promesoft/KicadJE_LIB/aj_symbols/lib_master/KiCAD Schematic Library Format.xlsx

Sheet: Schematic Decal Header
Comment | Component Name
#
# | 74LS04
#

Sheet: Schematic Decal Definition
Schematic Decal Definition
DEF 74HCT04 U 0 30 Y Y 6 F N |  |  |  |  |  |  |  |  |  | DEF 74HCT04 U 0 0 Y Y 6 F N
Defininition Statement | Decal Name | Default Ref Des |  | Skew | Show Pin Num | Show Pin Name | Num Parts | Locked | Power
DEF | 74LS02 | U | 0 | 30 | Y | Y | 6 | F | N

Sheet: Schematic Text Field Definition
Schematic Text Field Definition
F0 "U" 150 100 40 H V C CNN
F1 "74HCT04" 200 -100 40 H V C CNN
 |  |  |  |  |  |  |  |  | Text Style
Text Field Designator | Text | X Pos | Y Pos | Text Size | Text Direction | Visibility | Horz Just | Vert Just | Normal Italic | Normal Bold
F0 | "U" | 150 | 100 | 40 | H | V | C | C | N | N | No spaces between last three characters
F1 | "74HCT04" | 200 | -100 | 40 | H | V | C | C | N | N

Sheet: Schematic Alias Definition
Schematic Alias Definition
ALIAS 74HC14 74HC04 74LS14
Alias Designator | Alias 1 | Alias 2 | Alias 3 | Alias n
ALIAS | 74HC14 | 74HC04 | 74LS14

Sheet: Schematic Draw Definition
Schematic Draw Definition
P 4 0 0 0 -150 150 -150 -150 150 0 -150 150 N
DRAW
Line Style | Num Points |  |  |  | Point 1 X Coord | Point 1 Y Coord | Point 2 X Coord | Point 2 Y Coord | Point 3 X Coord | Point 3 Y Coord | Point 4 X Coord | Point 4 Y Coord | Fill Options
P | 4 | 0 | 0 | 0 | -150 | 150 | -150 | -150 | 150 | 0 | -150 | 150 | N

Sheet: Schematic Pin Definition
Schematic Pin Definition
X GND 7 -50 -100 0 U 30 20 0 0 W N
X ~ 1 -450 0 300 R 60 60 1 1 I
X ~ 2 450 0 300 L 60 60 1 1 O I
Field Names
Pin Designator | Pin Name | Pin Num | Pos | Pos
X | GND | 7 | -50 | -100 | 0 | U | 30 | 20 | 0 | 0 | W | N
X | ~ | 1 | -450 | 0 | 300 | R | 60 | 60 | 1 | 1 | I
X | ~ | 2 | 450 | 0 | 300 | L | 60 | 60 | 1 | 1 | I
