promesoft/KicadJE_LIB/aj_packages3d/3D/Switch/SPDT-draft.png

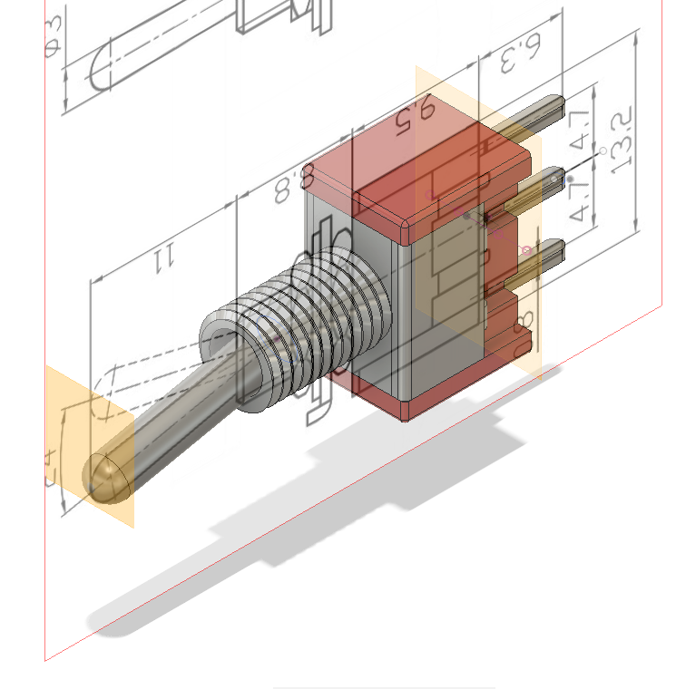
aj_packages3d/3D/Switch/SPDT-draft.png
