promesoft/KicadJE_LIB/aj_templates/MikroBUS_Board_L_Template/meta/brd.png

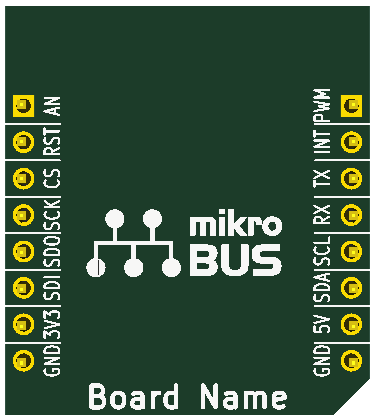
aj_templates/MikroBUS_Board_L_Template/meta/brd.png
