promesoft/KicadJE_LIB/aj_templates/XBee/meta/brd.png

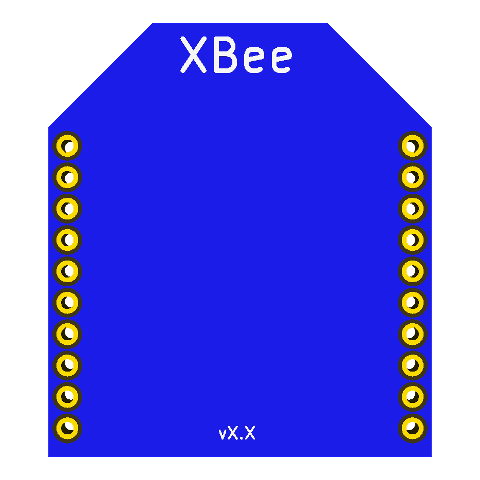
aj_templates/XBee/meta/brd.png
