promesoft/KicadJE_LIB/aj_templates/XBee/XBee_Info/XBee_Standard_Pinout.PNG

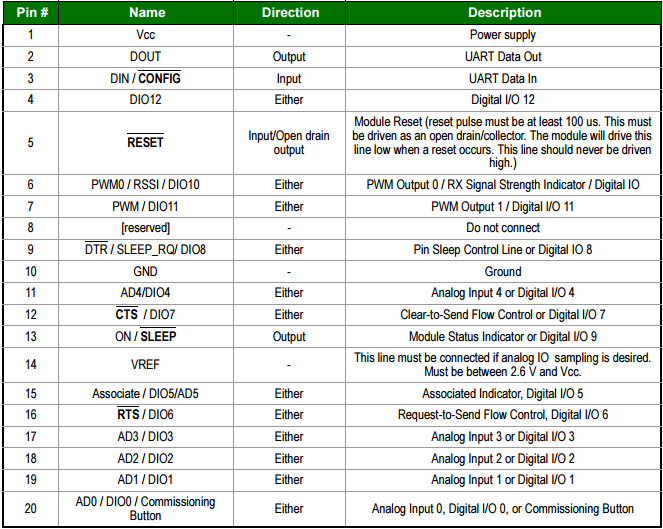
aj_templates/XBee/XBee_Info/XBee_Standard_Pinout.PNG
