promesoft/KicadJE_LIB/aj_templates/XBee_Pro/meta/brd.png

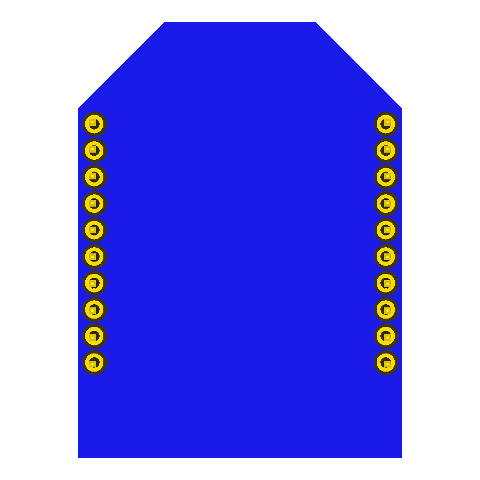
aj_templates/XBee_Pro/meta/brd.png
