promesoft/KicadJE_LIB/aj_symbols/lib_master/KiCAD_Schematic_Library_Info.ods

Sheet: Library_Names
74xx
Active
Altera
ARM
AVR
Battery
CMOS
Connector
Display
Electromechanical
Fuse
Header
IC
MSP430
PIC
Passive
Potentiometer
Power Supplies
RF_Modules
Terminal Block
Test_Point
TI_Luminary
TI_MSP430
Xilinx

Sheet: Active
DIODE
NPN
N_MOSFET
P_MOSFET
PNP
TRIAC
SCR

Sheet: Header
Schematic Component Name | Component Type | Gender | Pitch |  | Rows | Positions | Mounting Type
HEADER_100MIL_1R01P_SMT | HEADER | FEMALE | 100 | MIL | 1 | 01 | SMT
HEADER_100MIL_1R02P_SMT | HEADER | FEMALE | 100 | MIL | 1 | 02 | SMT
HEADER_100MIL_1R03P_SMT | HEADER | FEMALE | 100 | MIL | 1 | 03 | SMT
HEADER_100MIL_1R04P_SMT | HEADER | FEMALE | 100 | MIL | 1 | 04 | SMT
HEADER_100MIL_1R05P_SMT | HEADER | FEMALE | 100 | MIL | 1 | 05 | SMT
HEADER_100MIL_1R06P_SMT | HEADER | FEMALE | 100 | MIL | 1 | 06 | SMT
HEADER_100MIL_1R07P_SMT | HEADER | FEMALE | 100 | MIL | 1 | 07 | SMT
HEADER_100MIL_1R08P_SMT | HEADER | FEMALE | 100 | MIL | 1 | 08 | SMT
HEADER_100MIL_1R09P_SMT | HEADER | FEMALE | 100 | MIL | 1 | 09 | SMT
HEADER_100MIL_1R10P_SMT | HEADER | FEMALE | 100 | MIL | 1 | 10 | SMT
HEADER_100MIL_1R11P_SMT | HEADER | FEMALE | 100 | MIL | 1 | 11 | SMT
HEADER_100MIL_1R12P_SMT | HEADER | FEMALE | 100 | MIL | 1 | 12 | SMT
HEADER_100MIL_1R13P_SMT | HEADER | FEMALE | 100 | MIL | 1 | 13 | SMT
HEADER_100MIL_1R14P_SMT | HEADER | FEMALE | 100 | MIL | 1 | 14 | SMT
HEADER_100MIL_1R15P_SMT | HEADER | FEMALE | 100 | MIL | 1 | 15 | SMT
HEADER_100MIL_1R16P_SMT | HEADER | FEMALE | 100 | MIL | 1 | 16 | SMT
HEADER_100MIL_1R17P_SMT | HEADER | FEMALE | 100 | MIL | 1 | 17 | SMT
HEADER_100MIL_1R18P_SMT | HEADER | FEMALE | 100 | MIL | 1 | 18 | SMT
HEADER_100MIL_1R19P_SMT | HEADER | FEMALE | 100 | MIL | 1 | 19 | SMT
HEADER_100MIL_1R20P_SMT | HEADER | FEMALE | 100 | MIL | 1 | 20 | SMT
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
HEADER_100MIL_2R30P_PTH | HEADER | MALE | 100 | MIL | 2 | 30 | PTH
HEADER_100MIL_2R31P_PTH | HEADER | MALE | 100 | MIL | 2 | 31 | PTH
HEADER_100MIL_2R32P_PTH | HEADER | MALE | 100 | MIL | 2 | 32 | PTH
HEADER_100MIL_2R33P_PTH | HEADER | MALE | 100 | MIL | 2 | 33 | PTH
HEADER_100MIL_2R34P_PTH | HEADER | MALE | 100 | MIL | 2 | 34 | PTH
HEADER_100MIL_2R35P_PTH | HEADER | MALE | 100 | MIL | 2 | 35 | PTH
HEADER_100MIL_2R36P_PTH | HEADER | MALE | 100 | MIL | 2 | 36 | PTH
HEADER_100MIL_2R37P_PTH | HEADER | MALE | 100 | MIL | 2 | 37 | PTH
HEADER_100MIL_2R38P_PTH | HEADER | MALE | 100 | MIL | 2 | 38 | PTH
HEADER_100MIL_2R39P_PTH | HEADER | MALE | 100 | MIL | 2 | 39 | PTH
HEADER_100MIL_2R40P_PTH | HEADER | MALE | 100 | MIL | 2 | 40 | PTH
HEADER_100MIL_2R41P_PTH | HEADER | MALE | 100 | MIL | 2 | 41 | PTH
HEADER_100MIL_2R42P_PTH | HEADER | MALE | 100 | MIL | 2 | 42 | PTH
HEADER_100MIL_2R43P_PTH | HEADER | MALE | 100 | MIL | 2 | 43 | PTH
HEADER_100MIL_2R44P_PTH | HEADER | MALE | 100 | MIL | 2 | 44 | PTH
HEADER_100MIL_2R45P_PTH | HEADER | MALE | 100 | MIL | 2 | 45 | PTH
HEADER_100MIL_2R46P_PTH | HEADER | MALE | 100 | MIL | 2 | 46 | PTH
HEADER_100MIL_2R47P_PTH | HEADER | MALE | 100 | MIL | 2 | 47 | PTH
HEADER_100MIL_2R48P_PTH | HEADER | MALE | 100 | MIL | 2 | 48 | PTH
HEADER_100MIL_2R49P_PTH | HEADER | MALE | 100 | MIL | 2 | 49 | PTH
HEADER_100MIL_2R50P_PTH | HEADER | MALE | 100 | MIL | 2 | 50 | PTH

Sheet: Passive
CAP
CAP_P
RES
IND

Sheet: Switch
SW_ROCKER_ON-OFF-ON
SW_SLIDE_4POS
SW_TOGGLE_4P2T_ON-OFF-ON
SW_TOGGLE_1P1T_ON-OFF
SW_TOGGLE_2P2T_ON-ON
SW_TOGGLE_4P2T_ON-MOM
SW_PUSH_1P1T_OFF-MOM
SW_PUSH_1P1T_OFF-ON
