promesoft/KicadJE_LIB/aj_packages3d/3D/Battery_Holders/STEP/BHCW.STEP

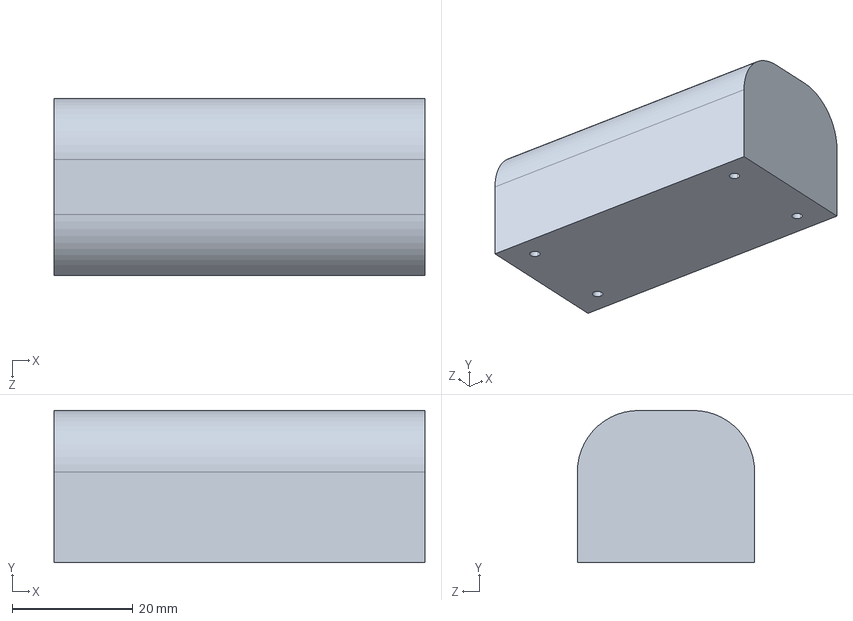
[picture p7: CAD file, 2021-04-10]
aj_packages3d/3D/Battery_Holders/STEP/BHCW.STEP
61.5 x 25.2 x 29.4 mm
