promesoft/KicadJE_LIB/aj_packages3d/3D/Connectors/JST/STEP/B4B-PH-K-S.step

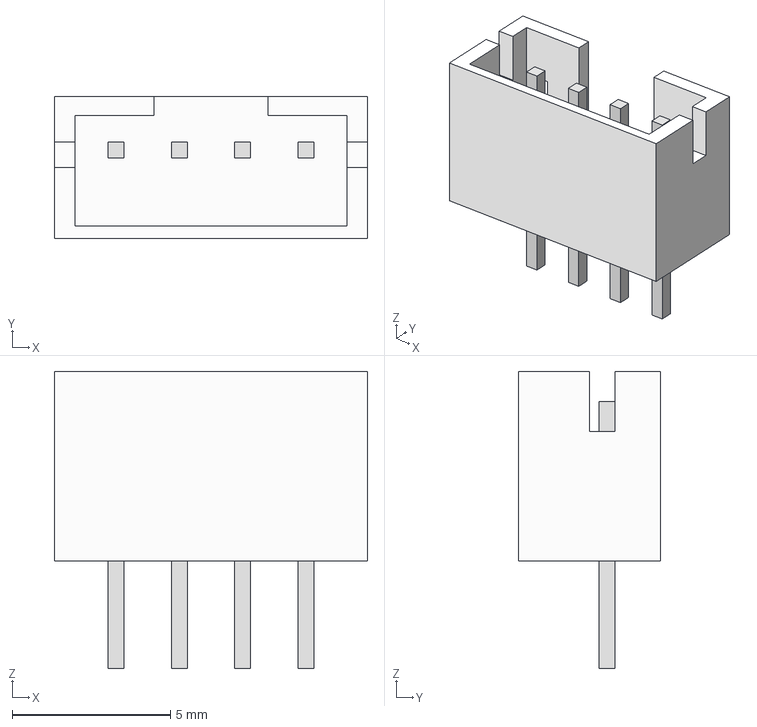
[picture p8: CAD file, 2021-04-10]
aj_packages3d/3D/Connectors/JST/STEP/B4B-PH-K-S.step
9.90 x 4.50 x 9.40 mm
