promesoft/KicadJE_LIB/aj_packages3d/3D/Connectors/PJ398SM.step

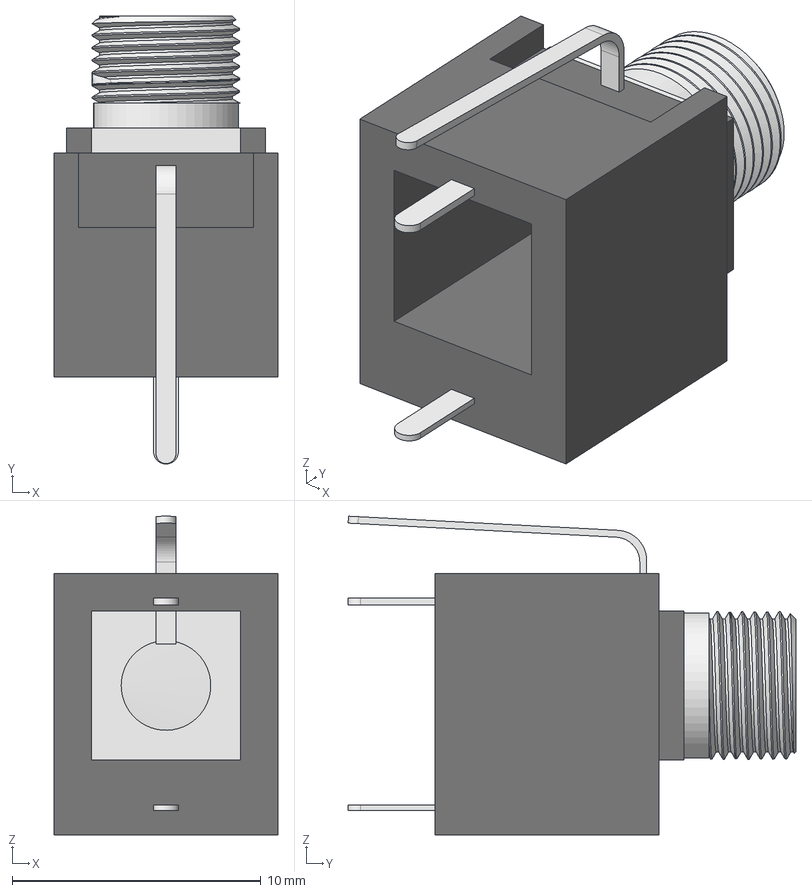
[picture p9: CAD file, 2021-04-10]
aj_packages3d/3D/Connectors/PJ398SM.step
9.00 x 18.0 x 12.8 mm
Barrel
Pins
