promesoft/KicadJE_LIB/aj_packages3d/3D/Connectors/Power/STEP/CUI_PJ-102AH.step

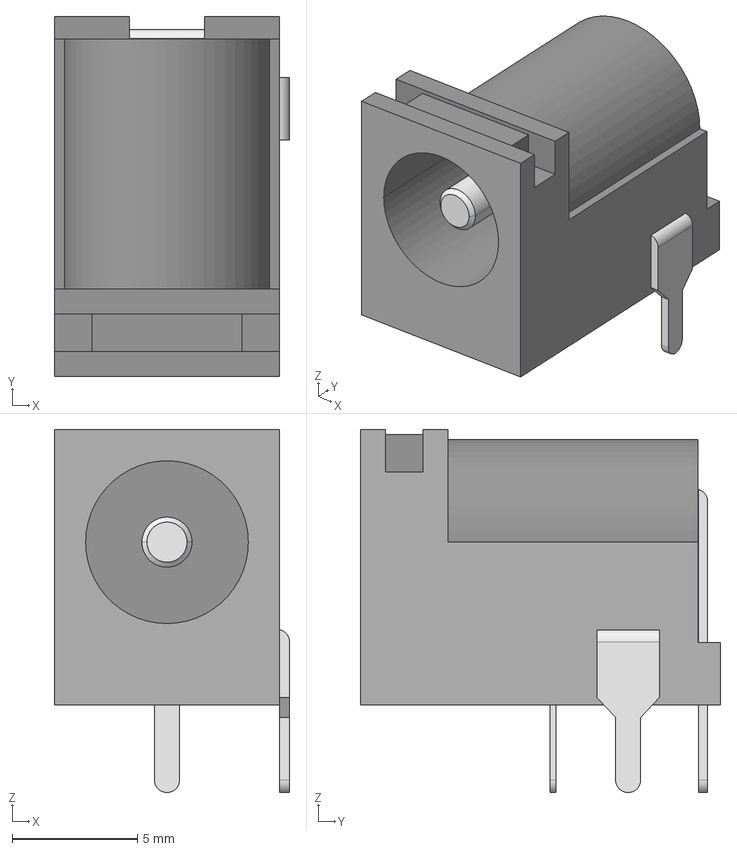
[picture p10: CAD file, 2021-04-10]
aj_packages3d/3D/Connectors/Power/STEP/CUI_PJ-102AH.step
9.40 x 14.4 x 14.5 mm
