promesoft/KicadJE_LIB/aj_packages3d/3D/Connectors/RF/STEP/UFL-R-SMT.step

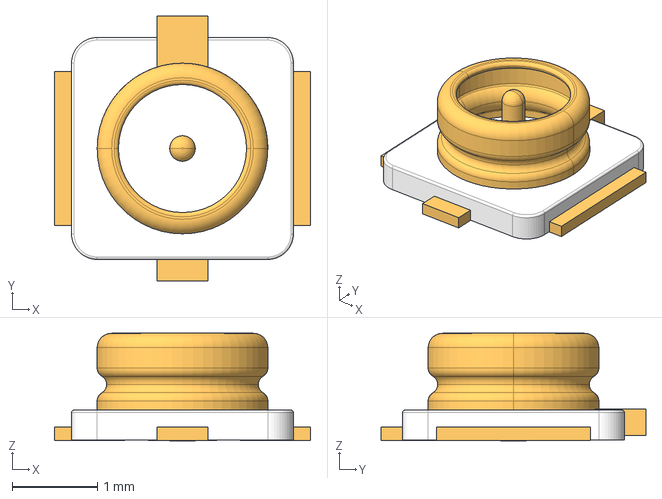
[picture p11: CAD file, 2021-04-10]
aj_packages3d/3D/Connectors/RF/STEP/UFL-R-SMT.step
3.00 x 3.10 x 1.26 mm
