promesoft/KicadJE_LIB/aj_packages3d/3D/Connectors/USB/STEP/MICRO_USB_VERT_SMT.step

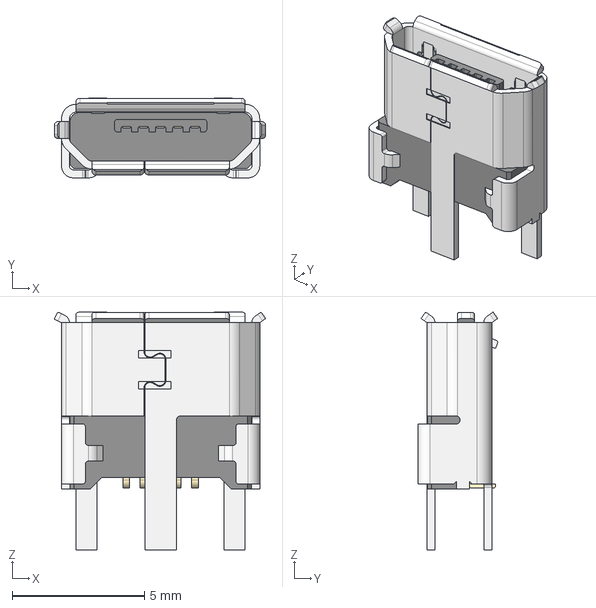
[picture p12: CAD file, 2021-04-10]
aj_packages3d/3D/Connectors/USB/STEP/MICRO_USB_VERT_SMT.step
8.00 x 3.01 x 9.01 mm
