promesoft/KicadJE_LIB/aj_packages3d/3D/Discrete/Active/STEP/MicroMELF.step

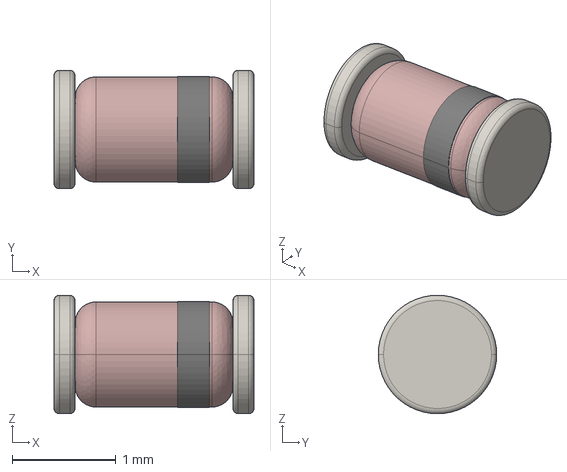
[picture p13: CAD file, 2021-04-10]
aj_packages3d/3D/Discrete/Active/STEP/MicroMELF.step
1.93 x 1.14 x 1.14 mm
