promesoft/KicadJE_LIB/aj_packages3d/3D/Discrete/Passive/Antenna/STEP/SW868-TH13.STEP

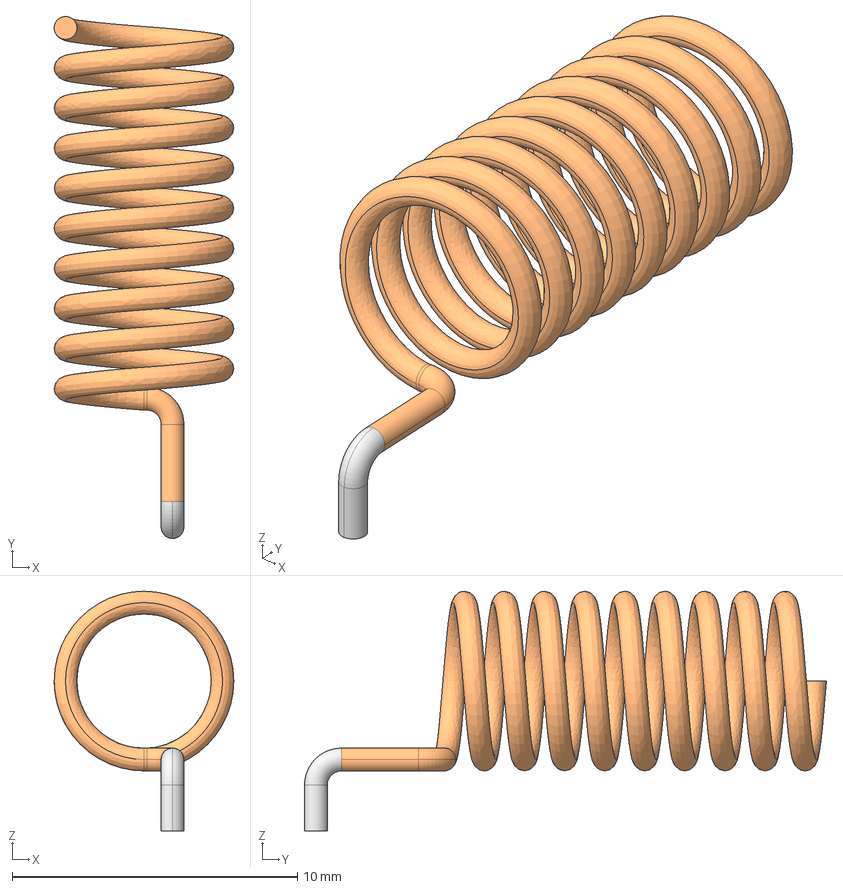
[picture p14: CAD file, 2021-04-10]
aj_packages3d/3D/Discrete/Passive/Antenna/STEP/SW868-TH13.STEP
6.30 x 18.3 x 8.40 mm
