promesoft/KicadJE_LIB/aj_packages3d/3D/Discrete/Passive/Capacitors/STEP/SMD Aluminum Electrolytic Capacitors 47uF 6,3V.STEP

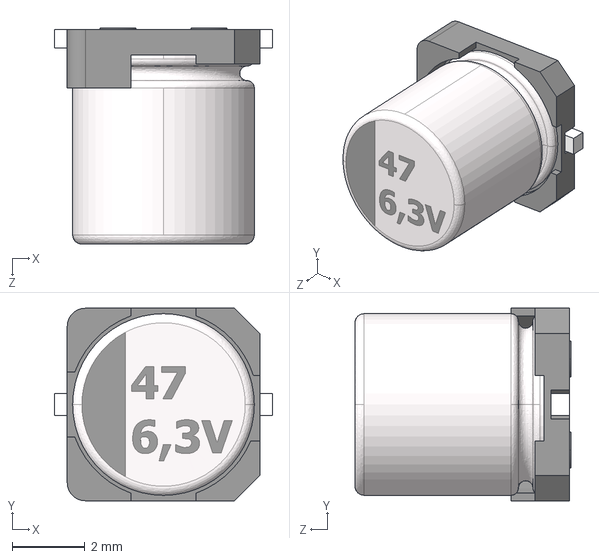
[picture p15: CAD file, 2021-04-10]
aj_packages3d/3D/Discrete/Passive/Capacitors/STEP/SMD Aluminum Electrolytic Capacitors 47uF 6,3V.STEP
6.00 x 5.30 x 5.95 mm
