promesoft/KicadJE_LIB/aj_packages3d/3D/Discrete/Passive/Crystals/STEP/FX135A-327.step

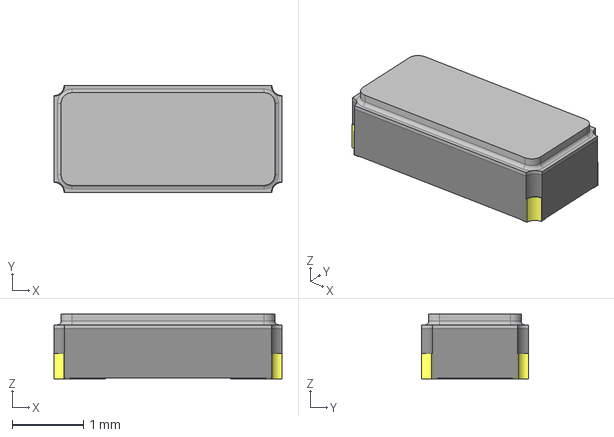
[picture p16: CAD file, 2021-04-10]
aj_packages3d/3D/Discrete/Passive/Crystals/STEP/FX135A-327.step
3.20 x 1.50 x 0.91 mm
