promesoft/KicadJE_LIB/aj_packages3d/3D/Discrete/Passive/Inductors/STEP/VLC6045.STEP

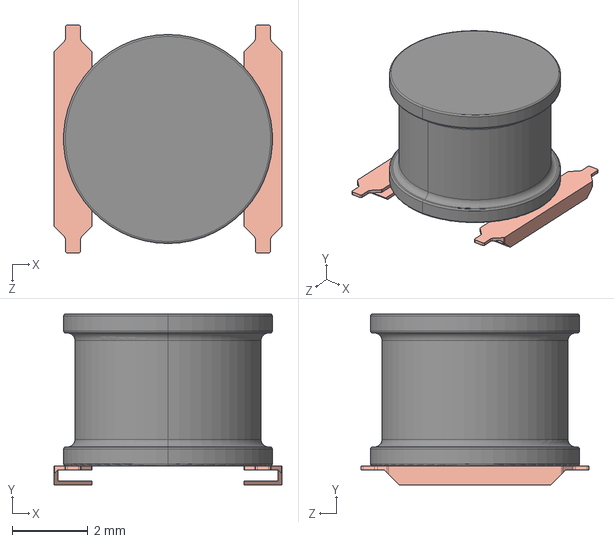
[picture p17: CAD file, 2021-04-10]
aj_packages3d/3D/Discrete/Passive/Inductors/STEP/VLC6045.STEP
6.00 x 4.50 x 6.00 mm
