promesoft/KicadJE_LIB/aj_packages3d/3D/Discrete/Passive/PTCs/STEP/PTC_0603.step

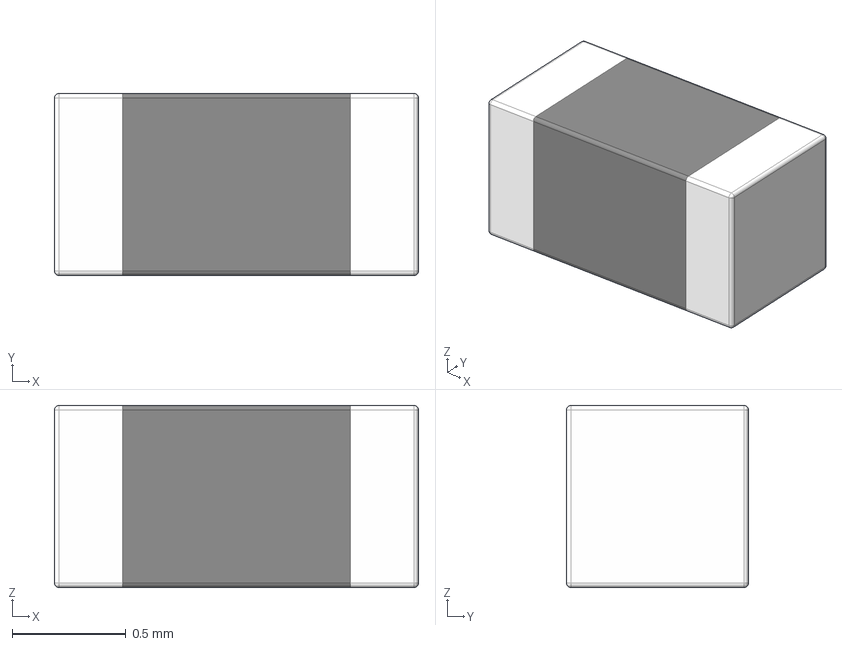
[picture p18: CAD file, 2021-04-10]
aj_packages3d/3D/Discrete/Passive/PTCs/STEP/PTC_0603.step
1.60 x 0.8 x 0.8 mm
