promesoft/KicadJE_LIB/aj_packages3d/3D/Discrete/Passive/Resistors/STEP/R0805.step

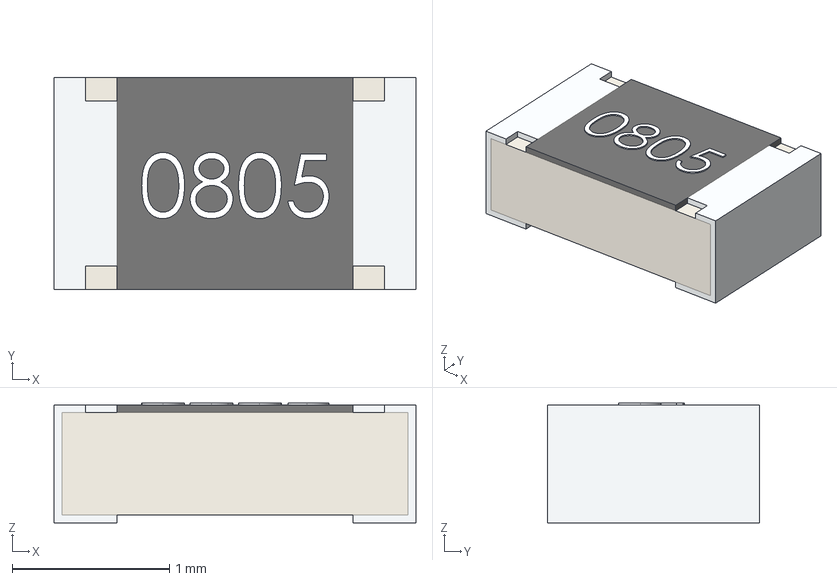
[picture p19: CAD file, 2021-04-10]
aj_packages3d/3D/Discrete/Passive/Resistors/STEP/R0805.step
2.30 x 1.35 x 0.76 mm
