promesoft/KicadJE_LIB/aj_packages3d/3D/Electromechanical/Pushbuttons/STEP/PTS810.step

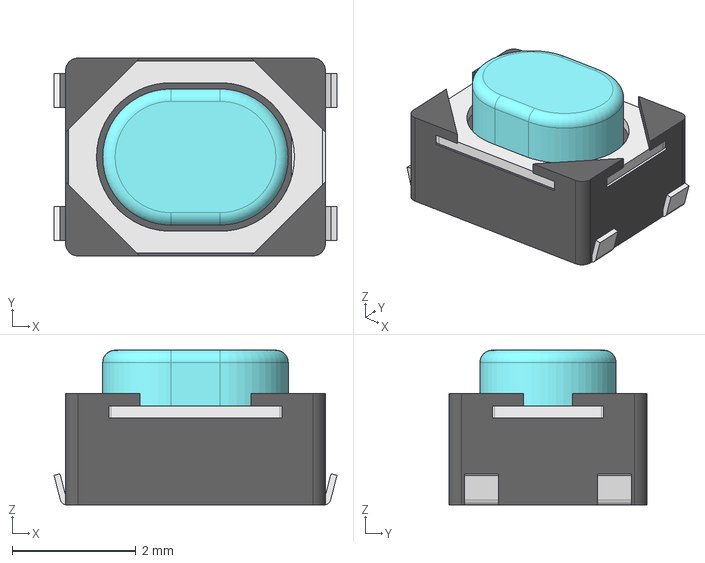
[picture p20: CAD file, 2021-04-10]
aj_packages3d/3D/Electromechanical/Pushbuttons/STEP/PTS810.step
4.58 x 3.20 x 2.50 mm
