promesoft/KicadJE_LIB/aj_packages3d/3D/Electromechanical/Relays/STEP/T9AS5D12.stp

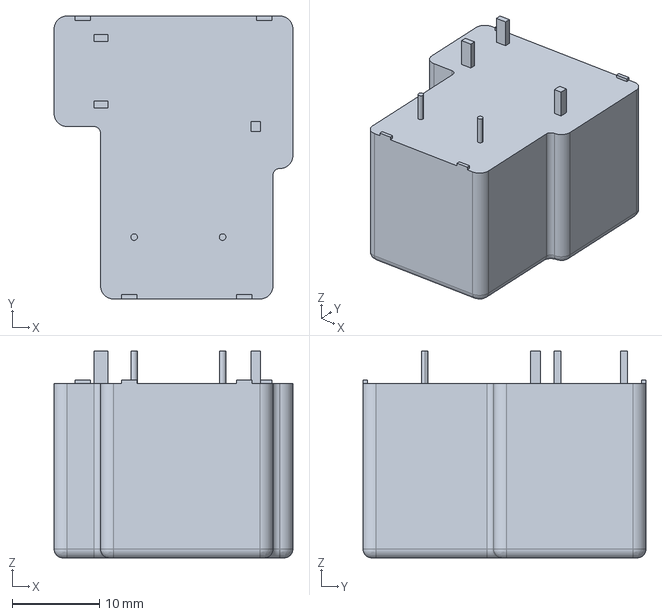
[picture p21: CAD file, 2021-04-10]
aj_packages3d/3D/Electromechanical/Relays/STEP/T9AS5D12.stp
27.4 x 32.5 x 23.7 mm
