promesoft/KicadJE_LIB/aj_packages3d/3D/Headers/STEP/HEADER_M_1.27MM_2R12P_ST_AU_SMT.step

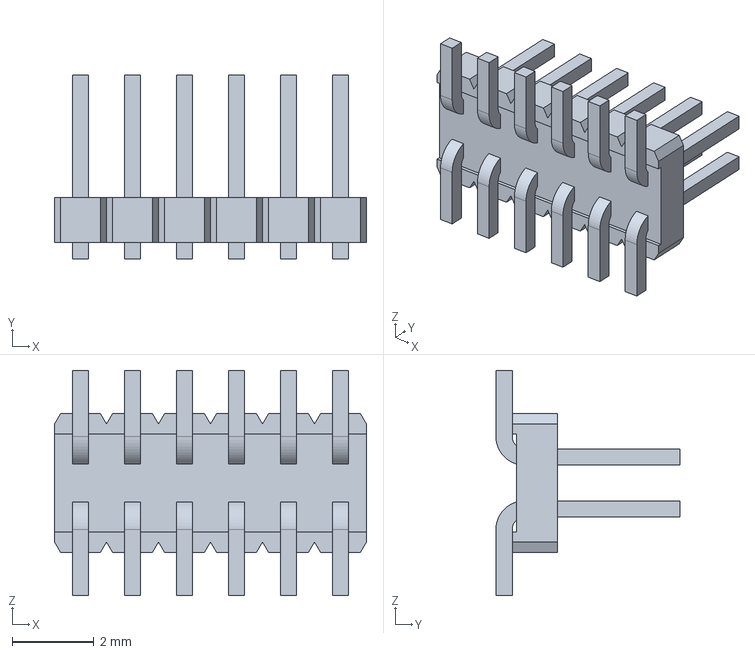
[picture p22: CAD file, 2021-04-10]
aj_packages3d/3D/Headers/STEP/HEADER_M_1.27MM_2R12P_ST_AU_SMT.step
7.62 x 4.50 x 5.50 mm
