promesoft/KicadJE_LIB/aj_packages3d/3D/ICs/DFN/STEP/DFN-8_2x3.step

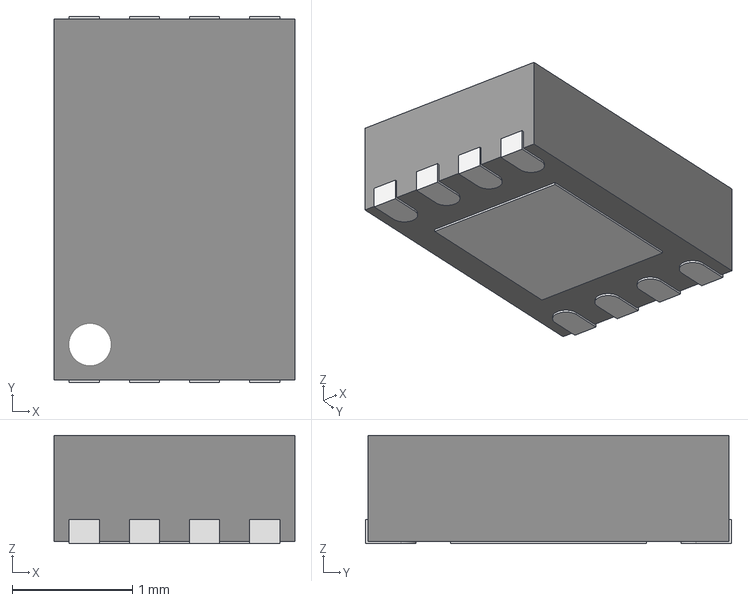
[picture p23: CAD file, 2021-04-10]
aj_packages3d/3D/ICs/DFN/STEP/DFN-8_2x3.step
2.00 x 3.04 x 0.901 mm
