promesoft/KicadJE_LIB/aj_packages3d/3D/ICs/SOIC/STEP/SOIC-8-150.step

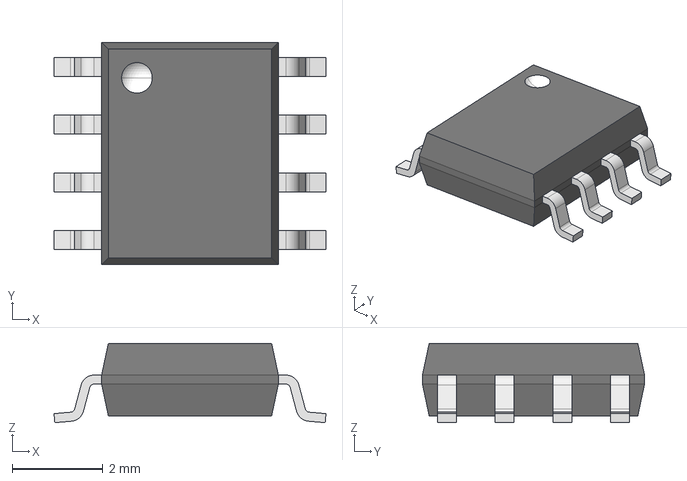
[picture p24: CAD file, 2021-04-10]
aj_packages3d/3D/ICs/SOIC/STEP/SOIC-8-150.step
6.00 x 4.90 x 1.75 mm
