promesoft/KicadJE_LIB/aj_packages3d/3D/ICs/SOT/STEP/SOT-23-3_GDS.step

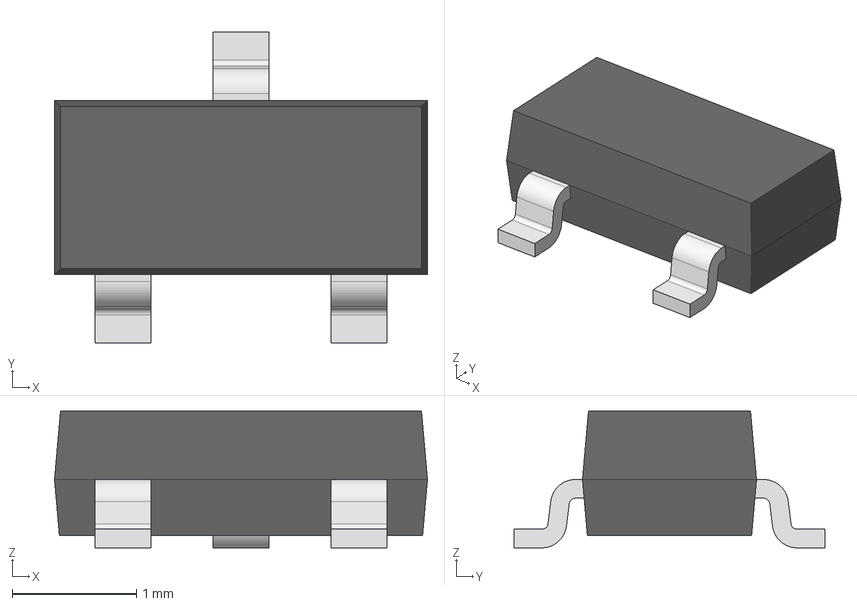
[picture p25: CAD file, 2021-04-10]
aj_packages3d/3D/ICs/SOT/STEP/SOT-23-3_GDS.step
3.00 x 2.50 x 1.10 mm
