promesoft/KicadJE_LIB/aj_packages3d/3D/LEDs/STEP/LED_0603_ORANGE.step

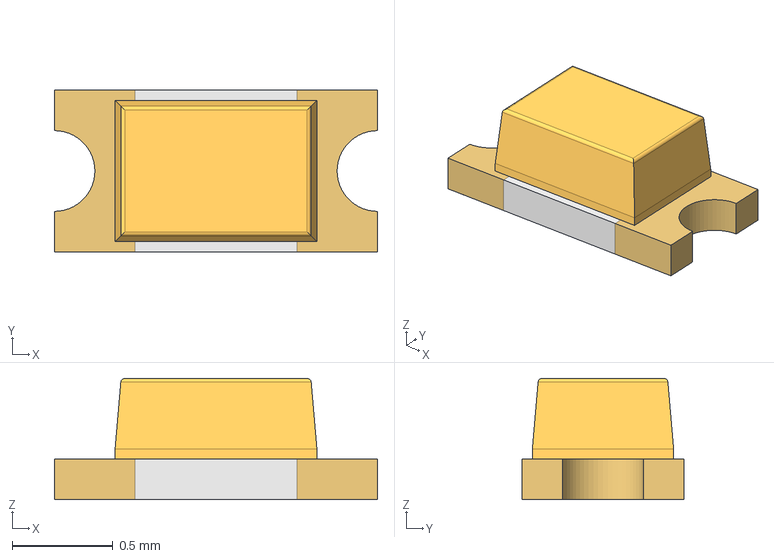
[picture p26: CAD file, 2021-04-10]
aj_packages3d/3D/LEDs/STEP/LED_0603_ORANGE.step
1.60 x 0.8 x 0.6 mm
