promesoft/KicadJE_LIB/aj_packages3d/3D/Modules/CAD/ArduinoMicro.SLDPRT

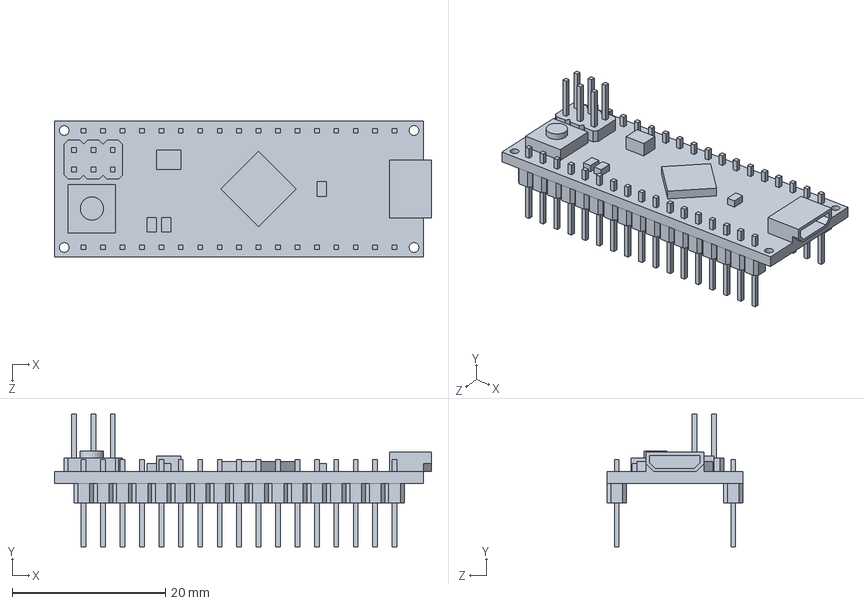
[picture p27: CAD file, 2021-04-10]
aj_packages3d/3D/Modules/CAD/ArduinoMicro.SLDPRT
49.3 x 17.3 x 17.8 mm
