promesoft/KicadJE_LIB/aj_packages3d/3D/Modules/STEP/Arduino_Pro_Mini.STEP

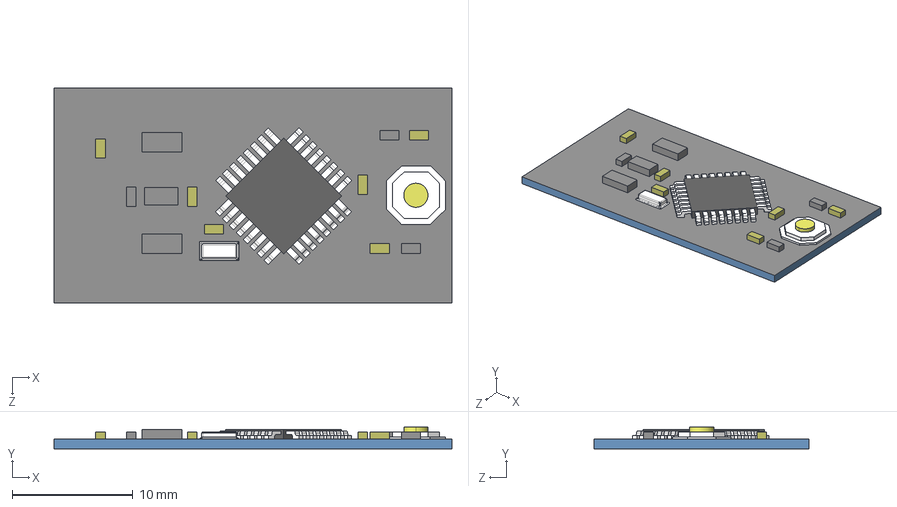
[picture p28: CAD file, 2021-04-10]
aj_packages3d/3D/Modules/STEP/Arduino_Pro_Mini.STEP
33.0 x 1.80 x 17.8 mm
