promesoft/KicadJE_LIB/aj_packages3d/3D/Potentiometers/RK097N.step

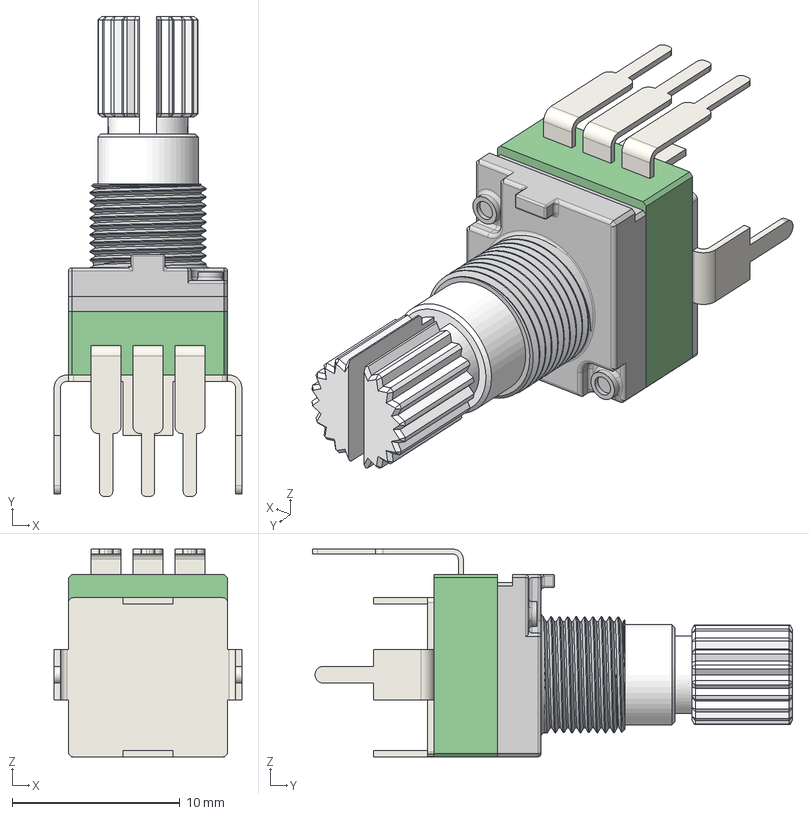
[picture p29: CAD file, 2021-04-10]
aj_packages3d/3D/Potentiometers/RK097N.step
11.2 x 28.6 x 12.4 mm
Casing
Pin x 3
Fixture
