promesoft/KicadJE_LIB/aj_packages3d/3D/Power_Supplies/AC_DC_Converters/CAD/Rohm_BP5039B12.SLDPRT

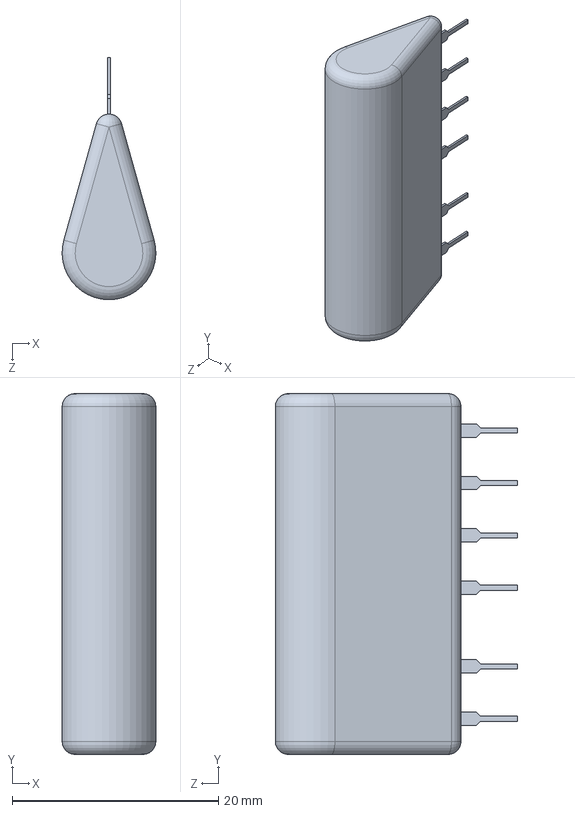
[picture p30: CAD file, 2021-04-10]
aj_packages3d/3D/Power_Supplies/AC_DC_Converters/CAD/Rohm_BP5039B12.SLDPRT
9.09 x 35.0 x 23.5 mm
