promesoft/KicadJE_LIB/aj_packages3d/3D/Power_Supplies/AC_DC_Converters/STEP/HiLink_HLK-PM03.STEP

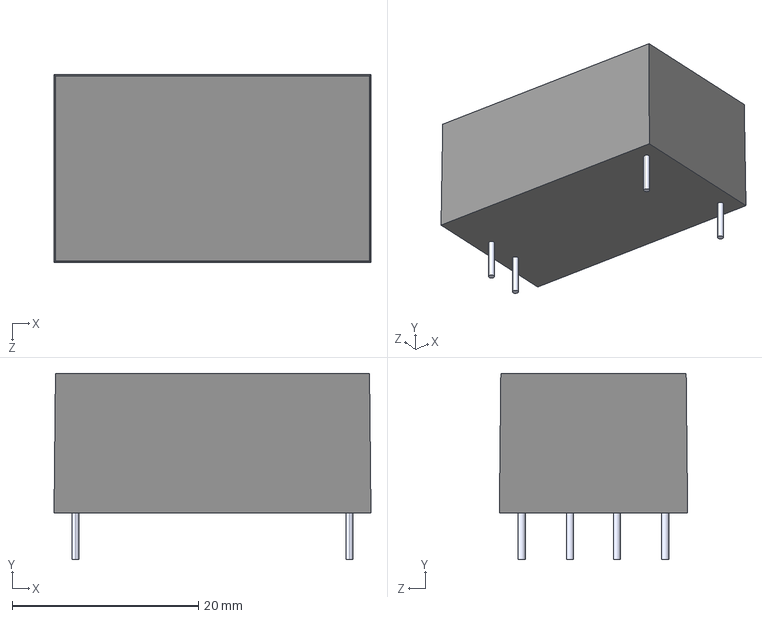
[picture p31: CAD file, 2021-04-10]
aj_packages3d/3D/Power_Supplies/AC_DC_Converters/STEP/HiLink_HLK-PM03.STEP
34.0 x 20.0 x 20.2 mm
