promesoft/KicadJE_LIB/aj_packages3d/3D/Power_Supplies/DC_DC_Converters/STEP/RECOM_RM-0505S.step

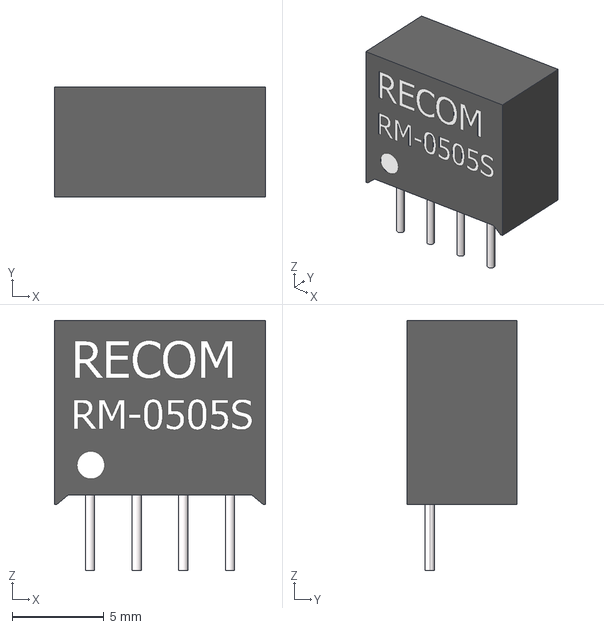
[picture p32: CAD file, 2021-04-10]
aj_packages3d/3D/Power_Supplies/DC_DC_Converters/STEP/RECOM_RM-0505S.step
11.5 x 6.00 x 13.6 mm
