promesoft/KicadJE_LIB/aj_packages3d/3D/RF_Modules/CAD/RFM95W.SLDPRT

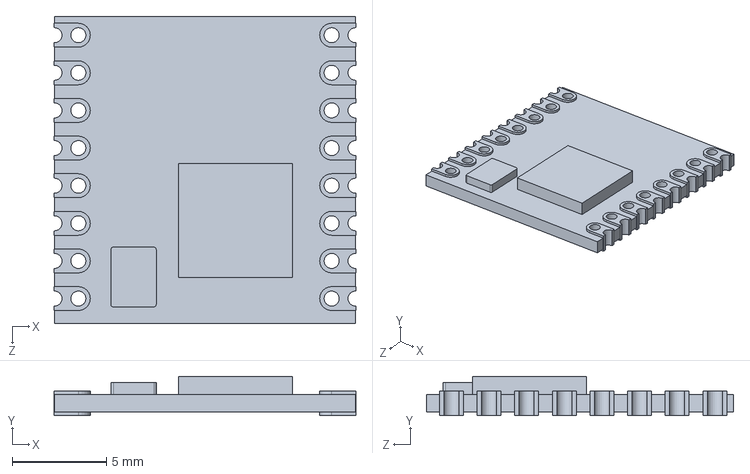
[picture p33: CAD file, 2021-04-10]
aj_packages3d/3D/RF_Modules/CAD/RFM95W.SLDPRT
16.1 x 2.08 x 16.3 mm
