promesoft/KicadJE_LIB/aj_packages3d/3D/RF_Modules/STEP/RFM96W.STEP

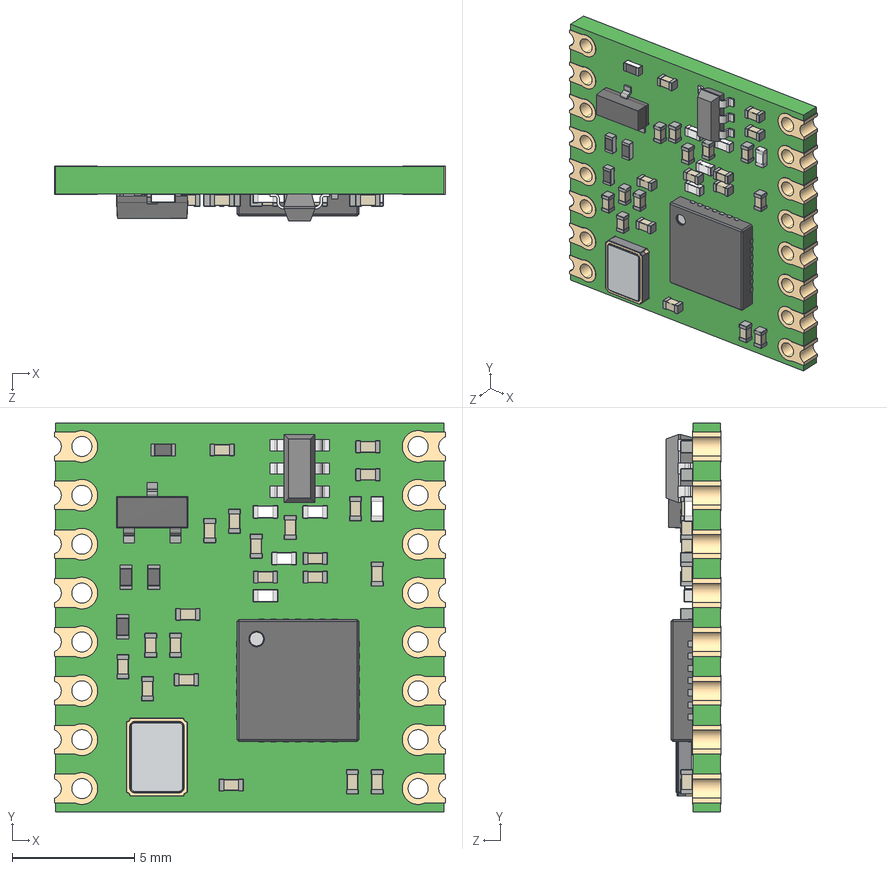
[picture p34: CAD file, 2021-04-10]
aj_packages3d/3D/RF_Modules/STEP/RFM96W.STEP
16.0 x 15.9 x 2.23 mm
User Library-RFM96W_Board
User Library-RFM96W_Cap0402 x 21
User Library-RFM96W_SW3dPS-inductor_0402_white x 5
User Library-RFM96W_SW3dPS-SOT-23-6
User Library-RFM96W_QFN28
User Library-RFM96W_TXC_7M
User Library-RFM96W_Res0402 x 4
User Library-RFM96W_User_Library-3-lead_sot23-3
User Library-RFM96W_Goldcontact x 16
