promesoft/KicadJE_LIB/aj_packages3d/3D/RF_Modules/STL/ESP-12_4wings.stl

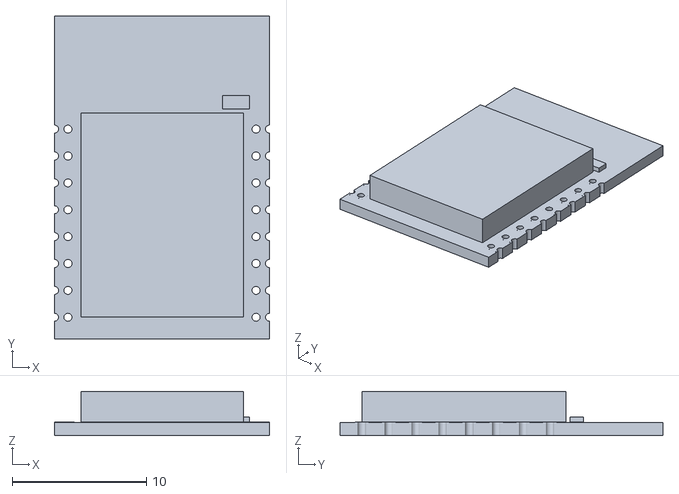
[picture p35: CAD file, 2021-04-10]
aj_packages3d/3D/RF_Modules/STL/ESP-12_4wings.stl
16.0 x 24.0 x 3.30
