promesoft/KicadJE_LIB/aj_packages3d/3D/Sensors/Current_Sense/STL/Talema_AC1005.stl

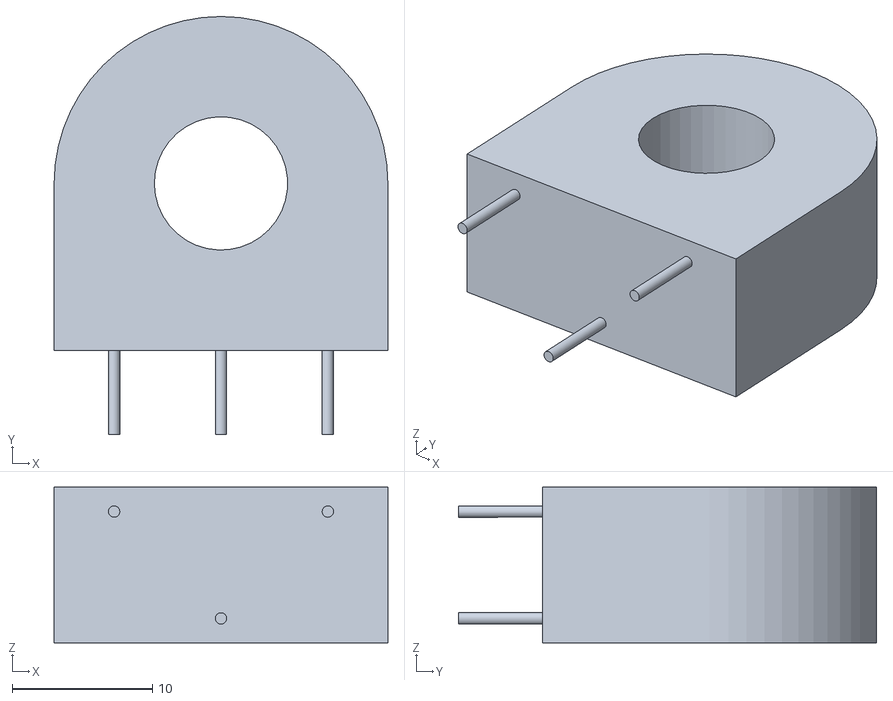
[picture p36: CAD file, 2021-04-10]
aj_packages3d/3D/Sensors/Current_Sense/STL/Talema_AC1005.stl
23.8 x 29.8 x 11.1
