promesoft/KicadJE_LIB/aj_packages3d/3D/Switch/SPDT.step

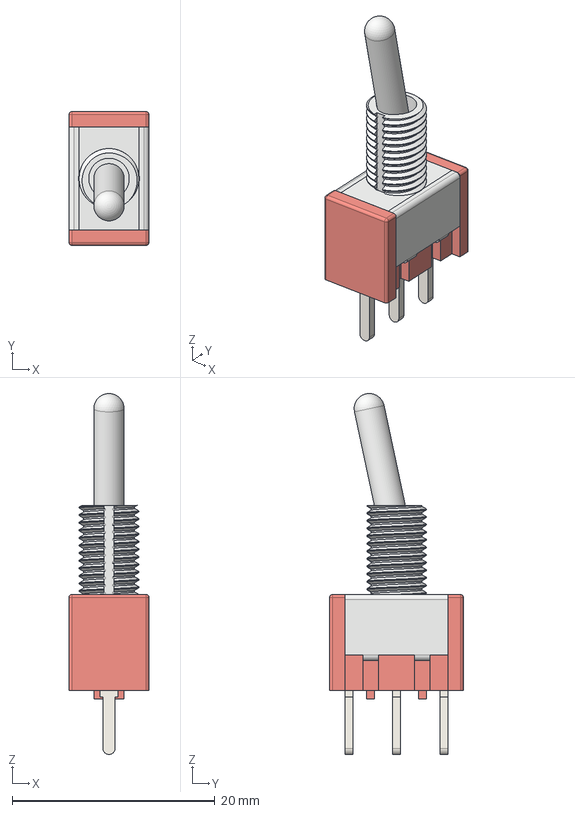
[picture p37: CAD file, 2021-04-10]
aj_packages3d/3D/Switch/SPDT.step
7.90 x 13.2 x 35.6 mm
Fixture
Pins
Arm
