promesoft/KicadJE_LIB/aj_packages3d/3D/Terminal_Blocks/CAD/OSTVN03A150.SLDPRT

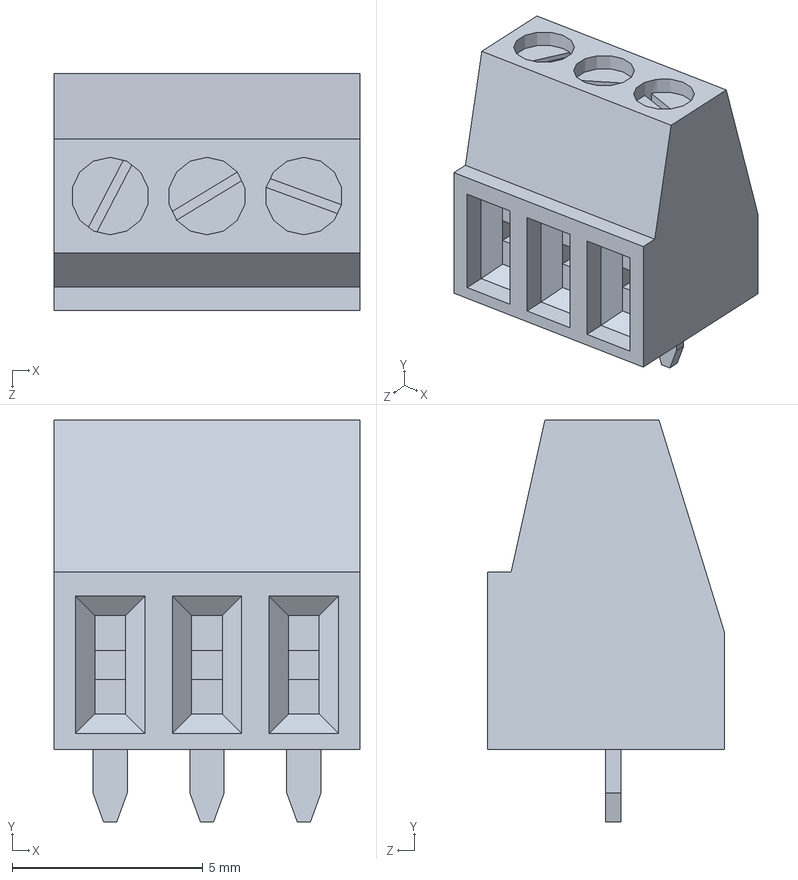
[picture p38: CAD file, 2021-04-10]
aj_packages3d/3D/Terminal_Blocks/CAD/OSTVN03A150.SLDPRT
8.02 x 10.5 x 6.22 mm
