promesoft/KicadJE_LIB/aj_packages3d/3D/Terminal_Blocks/IGES/c-282834-8-c-3d.igs

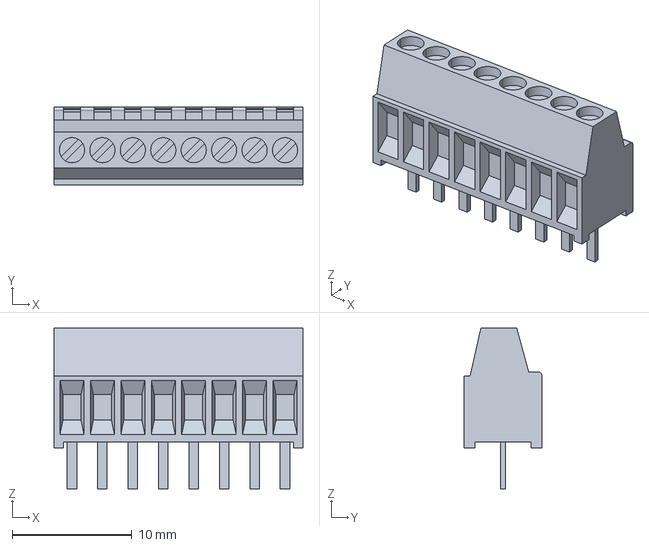
[picture p39: CAD file, 2021-04-10]
aj_packages3d/3D/Terminal_Blocks/IGES/c-282834-8-c-3d.igs
20.8 x 6.50 x 13.4 mm
