promesoft/KicadJE_LIB/aj_packages3d/3D/Test_Points/CAD/TEST_POINT_PTH_KEYSTONE_5117.SLDPRT

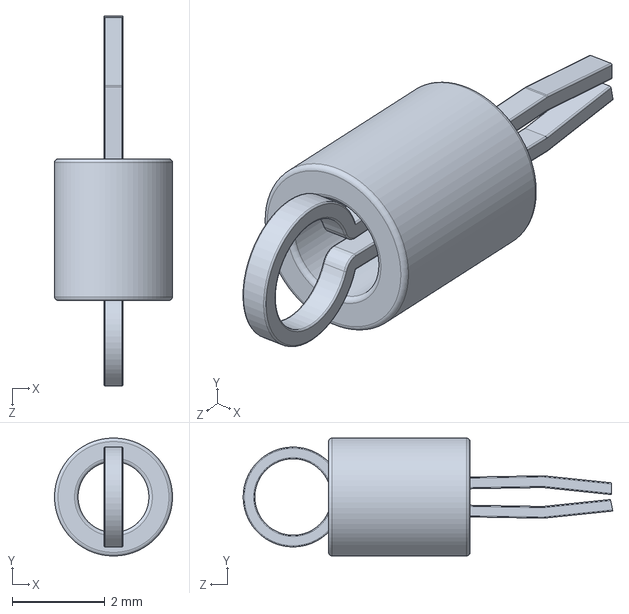
[picture p41: CAD file, 2021-04-10]
aj_packages3d/3D/Test_Points/CAD/TEST_POINT_PTH_KEYSTONE_5117.SLDPRT
2.54 x 2.54 x 7.96 mm
