promesoft/KicadJE_LIB/aj_packages3d/3D/Transducers/CAD/PS1240P02BT.FCStd

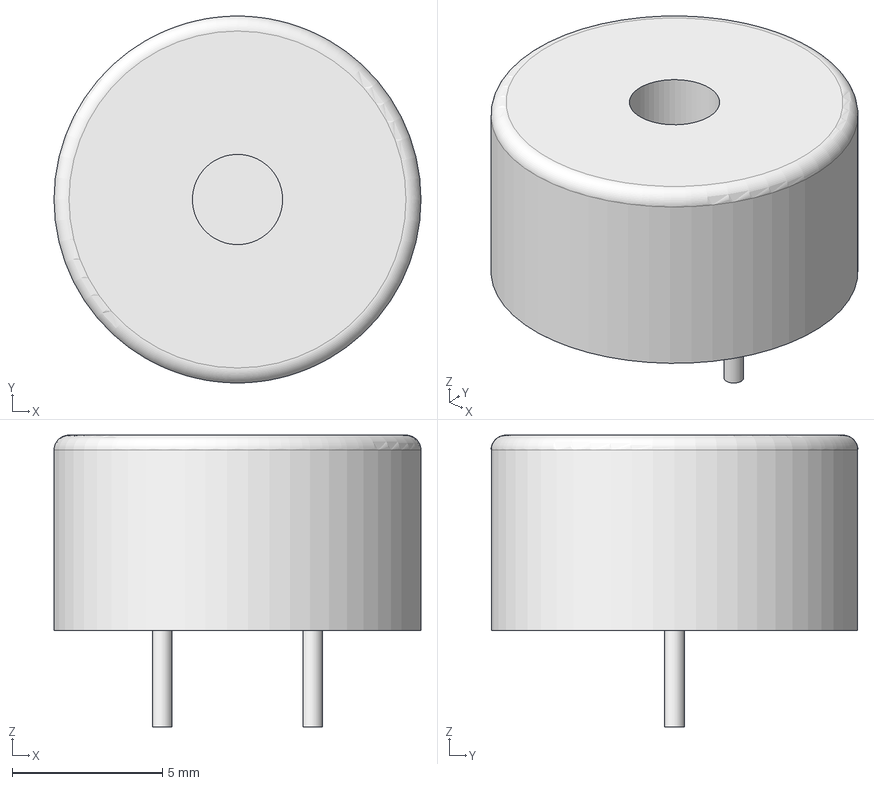
[picture p42: CAD file, 2021-04-10]
aj_packages3d/3D/Transducers/CAD/PS1240P02BT.FCStd
12.2 x 12.2 x 9.70 mm
