promesoft/KicadJE_LIB/aj_packages3d/3D/Connectors/JST/STEP/B4B-PH-SM4-TB.STEP

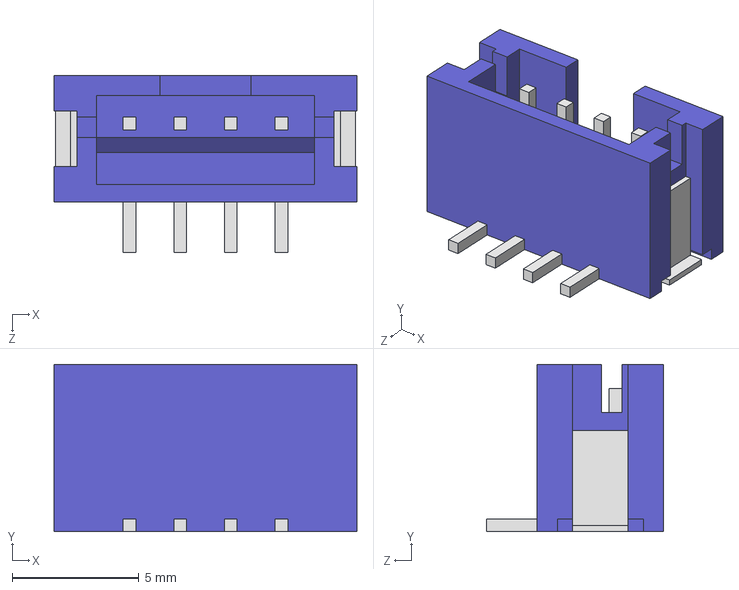
[picture p44: CAD file, 2021-04-10]
aj_packages3d/3D/Connectors/JST/STEP/B4B-PH-SM4-TB.STEP
12.0 x 6.60 x 7.00 mm
