promesoft/KicadJE_LIB/aj_packages3d/3D/Discrete/Active/STEP/DO-214AA.step

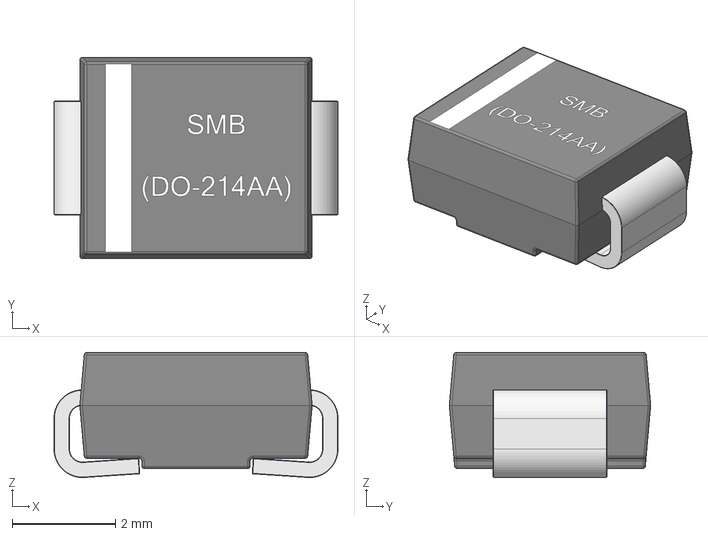
[picture p45: CAD file, 2021-04-10]
aj_packages3d/3D/Discrete/Active/STEP/DO-214AA.step
5.50 x 3.90 x 2.42 mm
