promesoft/KicadJE_LIB/aj_packages3d/3D/Discrete/Passive/Capacitors/STEP/SMD Aluminum Electrolytic Capacitors 100uF 6,3V.STEP

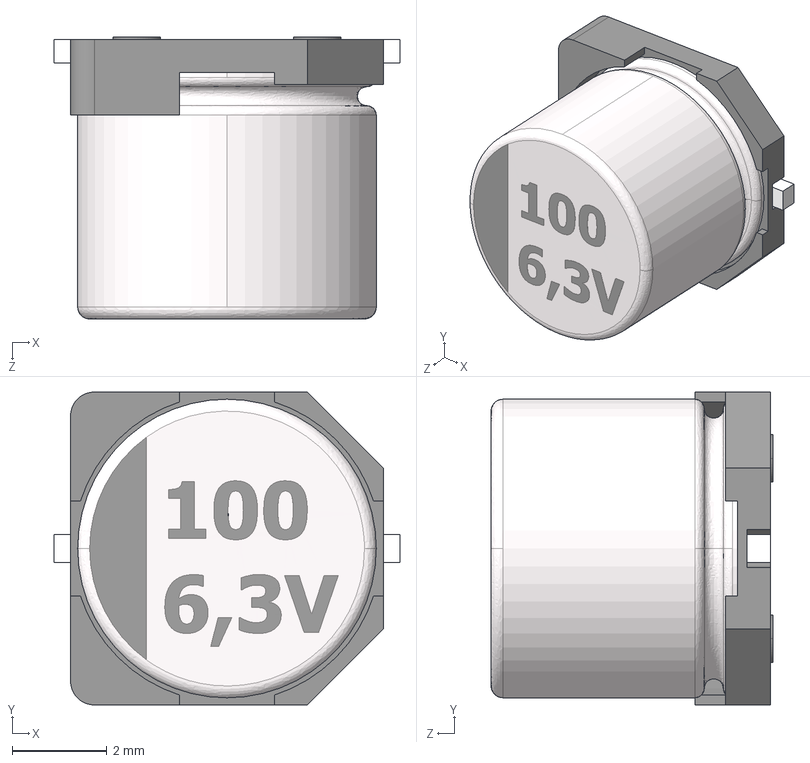
[picture p46: CAD file, 2021-04-10]
aj_packages3d/3D/Discrete/Passive/Capacitors/STEP/SMD Aluminum Electrolytic Capacitors 100uF 6,3V.STEP
7.30 x 6.60 x 5.95 mm
