promesoft/KicadJE_LIB/aj_packages3d/3D/Discrete/Passive/PTCs/STEP/PTC_0805.step

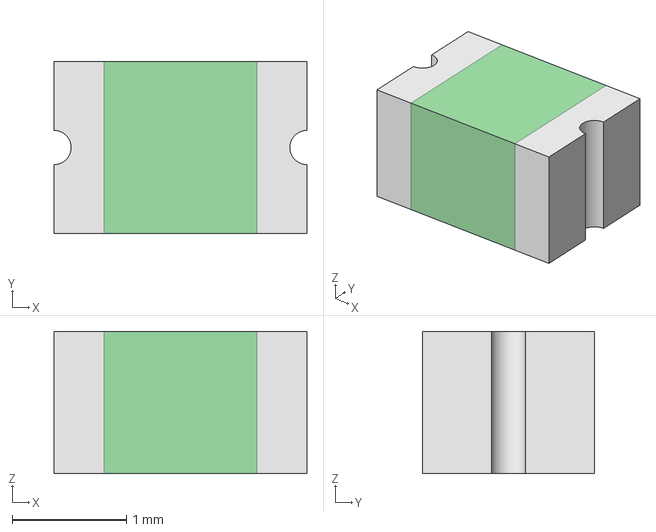
[picture p47: CAD file, 2021-04-10]
aj_packages3d/3D/Discrete/Passive/PTCs/STEP/PTC_0805.step
2.21 x 1.50 x 1.24 mm
