promesoft/KicadJE_LIB/aj_packages3d/3D/Discrete/Passive/Resistors/STEP/R1206.step

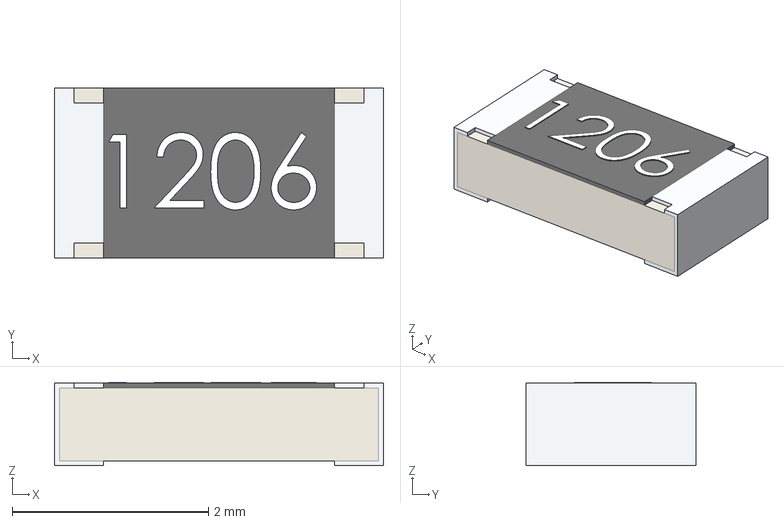
[picture p48: CAD file, 2021-04-10]
aj_packages3d/3D/Discrete/Passive/Resistors/STEP/R1206.step
3.35 x 1.73 x 0.85 mm
