promesoft/KicadJE_LIB/aj_packages3d/3D/Headers/STEP/HEADER_M_1.27MM_2R20P_ST_AU_SMT.step

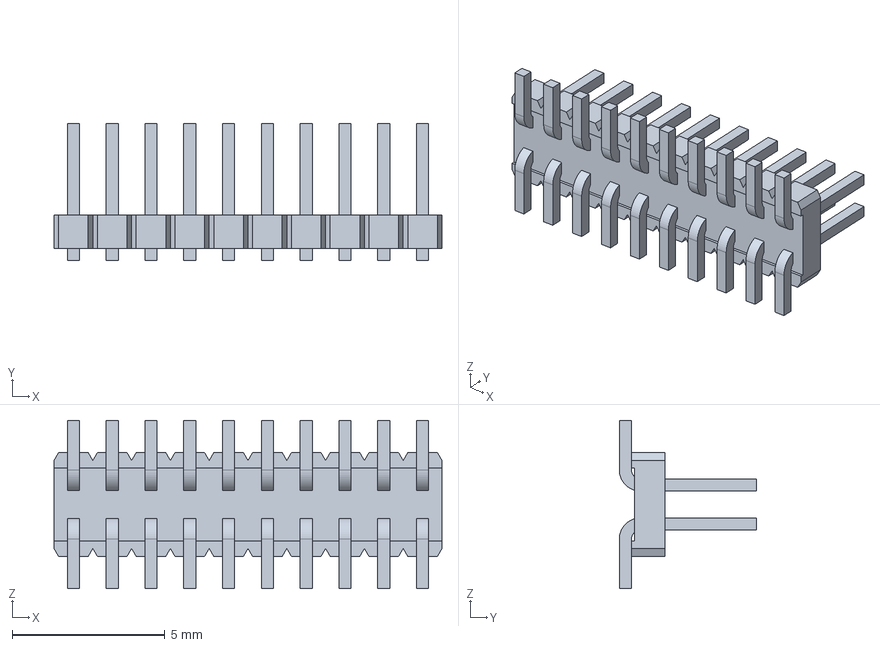
[picture p49: CAD file, 2021-04-10]
aj_packages3d/3D/Headers/STEP/HEADER_M_1.27MM_2R20P_ST_AU_SMT.step
12.7 x 4.50 x 5.50 mm
