promesoft/KicadJE_LIB/aj_packages3d/3D/Power_Supplies/AC_DC_Converters/STEP/SHANBO_SHB-5W.STEP

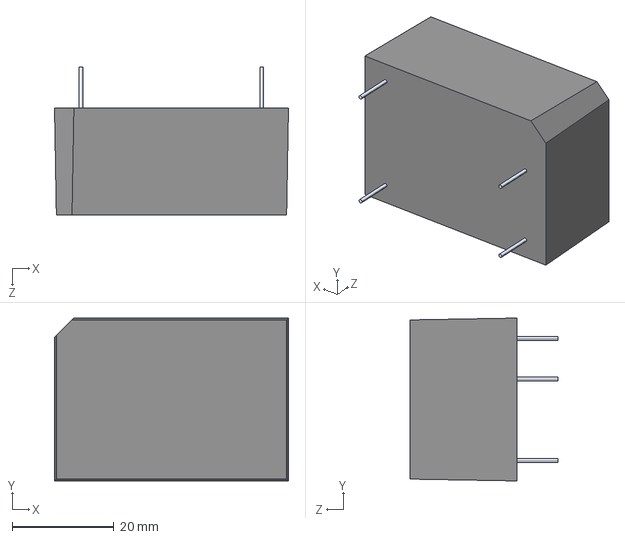
[picture p51: CAD file, 2021-04-10]
aj_packages3d/3D/Power_Supplies/AC_DC_Converters/STEP/SHANBO_SHB-5W.STEP
46.0 x 32.0 x 29.1 mm
