promesoft/KicadJE_LIB/aj_packages3d/3D/RF_Modules/CAD/UBLOX_GPS_NEO-6M.SLDPRT

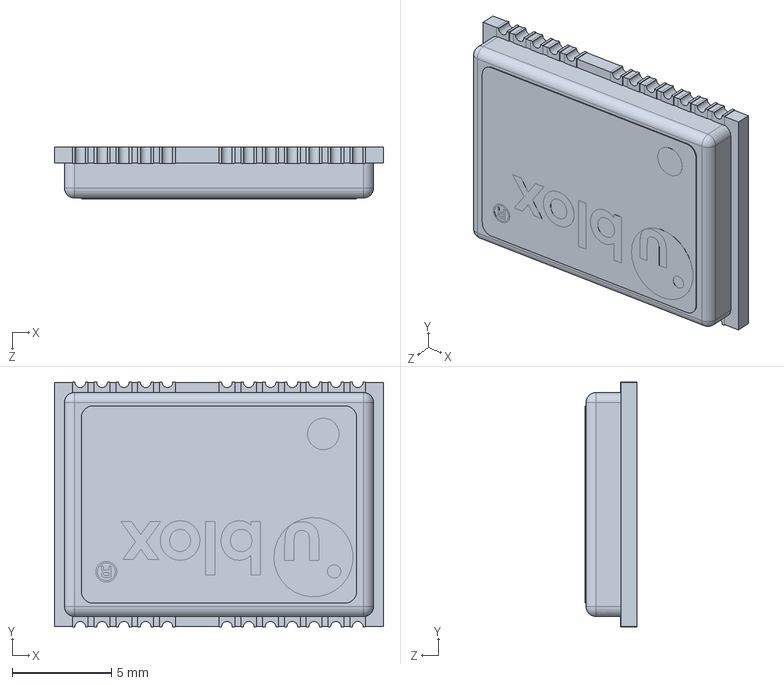
[picture p52: CAD file, 2021-04-10]
aj_packages3d/3D/RF_Modules/CAD/UBLOX_GPS_NEO-6M.SLDPRT
16.6 x 12.4 x 2.64 mm
