promesoft/KicadJE_LIB/aj_packages3d/3D/RF_Modules/STEP/RFM22B.STEP

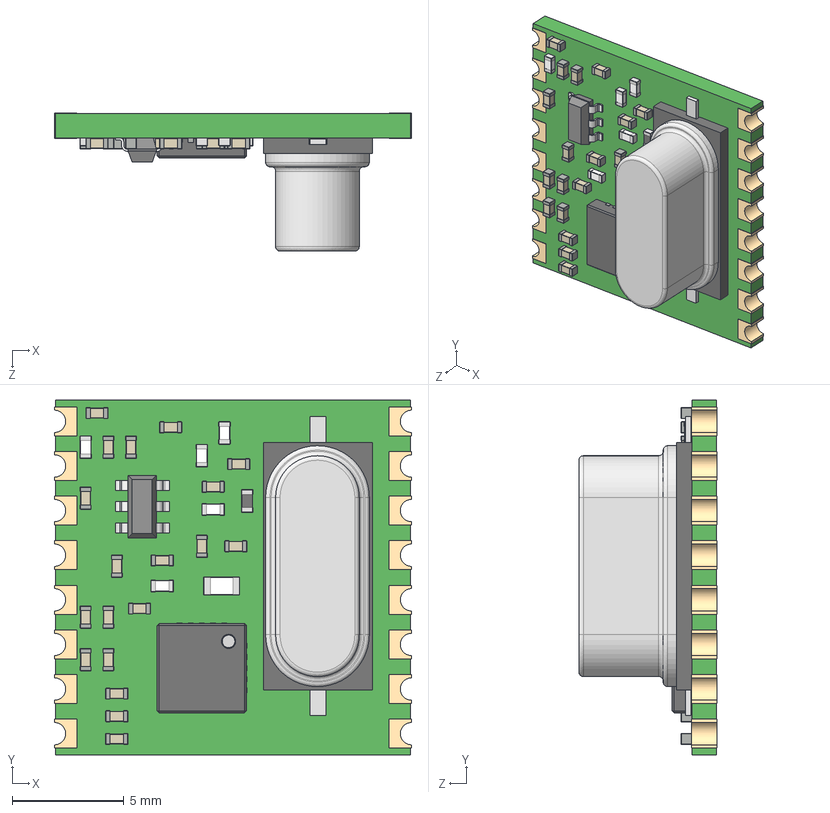
[picture p53: CAD file, 2021-04-10]
aj_packages3d/3D/RF_Modules/STEP/RFM22B.STEP
16.0 x 15.9 x 6.20 mm
User Library-RFM22B_Board
User Library-RFM22B_SW3dPS-inductor_0402
User Library-RFM22B_SW3dPS-SOT-23-6
User Library-RFM22B_Cap0402 x 19
User Library-RFM22B_SW3dPS-inductor_0402_white x 5
User Library-RFM22B_SW3dPS-inductor_0603_white
User Library-RFM22B_QFN20
User Library-RFM22B_SW3dPS-hc49_cystal
User Library-RFM22B_Goldcontact x 16
