promesoft/KicadJE_LIB/aj_packages3d/3D/RF_Modules/STL/ESP-13-wroom-02_4wings.stl

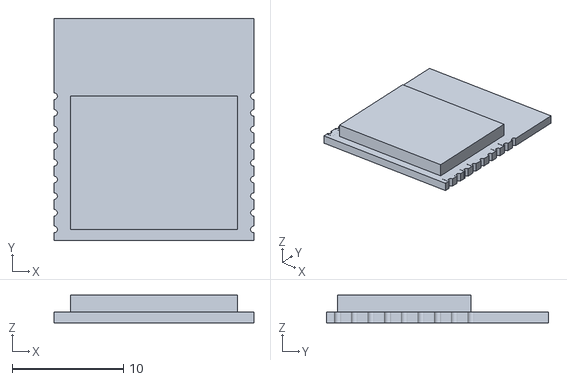
[picture p54: CAD file, 2021-04-10]
aj_packages3d/3D/RF_Modules/STL/ESP-13-wroom-02_4wings.stl
18.0 x 20.0 x 2.50
