promesoft/KicadJE_LIB/aj_packages3d/3D/Terminal_Blocks/CAD/OSTVN08A150.SLDPRT

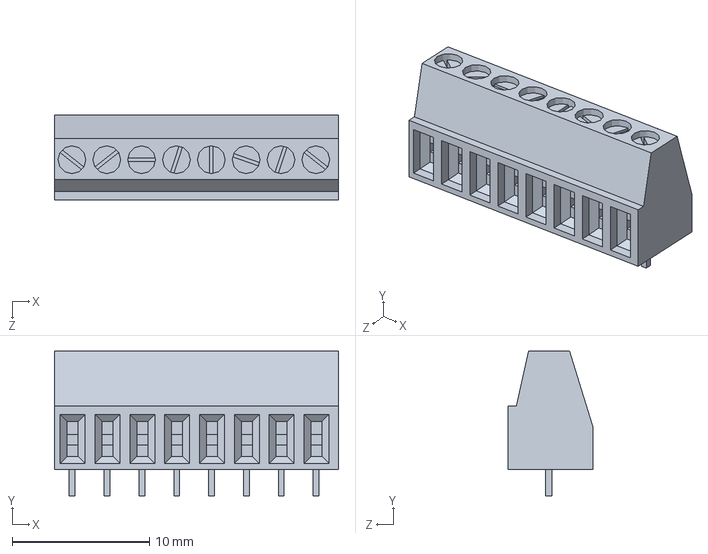
[picture p55: CAD file, 2021-04-10]
aj_packages3d/3D/Terminal_Blocks/CAD/OSTVN08A150.SLDPRT
20.7 x 10.5 x 6.22 mm
