promesoft/KicadJE_LIB/aj_packages3d/3D/Terminal_Blocks/STEP/TB_3.5MM_1R2P_HORZ_PTH_2PC_SOCKET.STEP

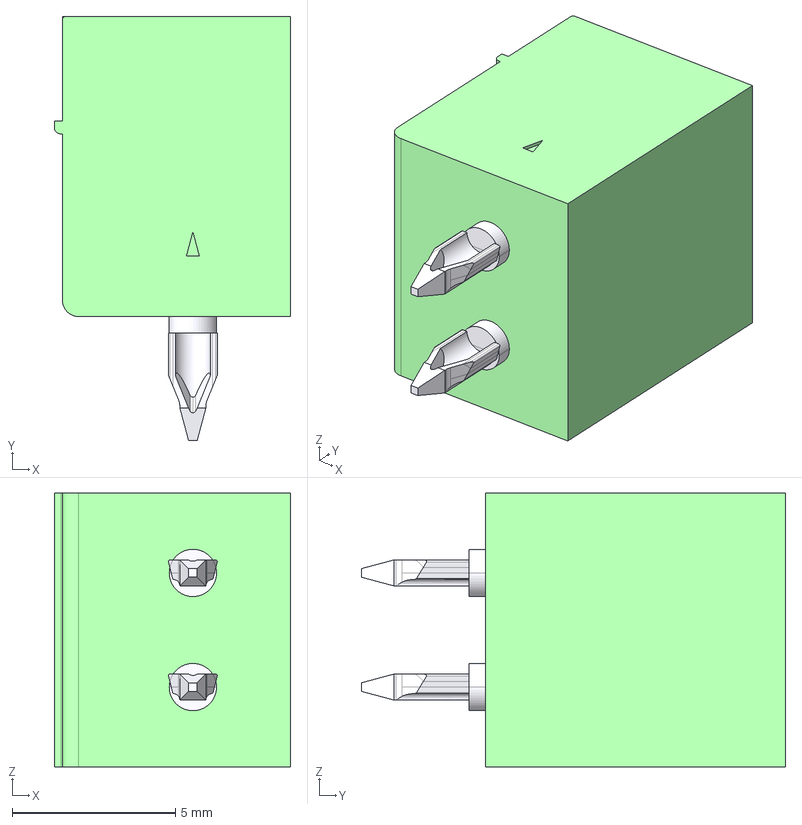
[picture p56: CAD file, 2021-04-10]
aj_packages3d/3D/Terminal_Blocks/STEP/TB_3.5MM_1R2P_HORZ_PTH_2PC_SOCKET.STEP
7.25 x 13.0 x 8.40 mm
