promesoft/KicadJE_LIB/aj_packages3d/3D/Terminal_Blocks/STL/PTSA.stl

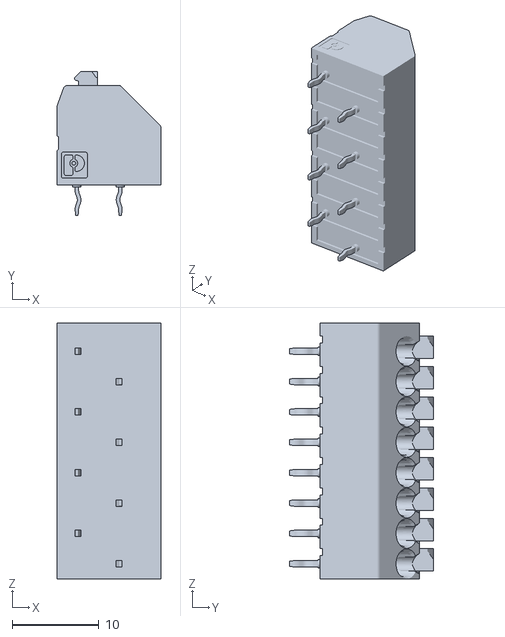
[picture p57: CAD file, 2021-04-10]
aj_packages3d/3D/Terminal_Blocks/STL/PTSA.stl
12.0 x 16.6 x 29.5
