promesoft/KicadJE_LIB/aj_packages3d/3D/Test_Points/CAD/TEST_POINT_SMT_KEYSTONE_5015.SLDPRT

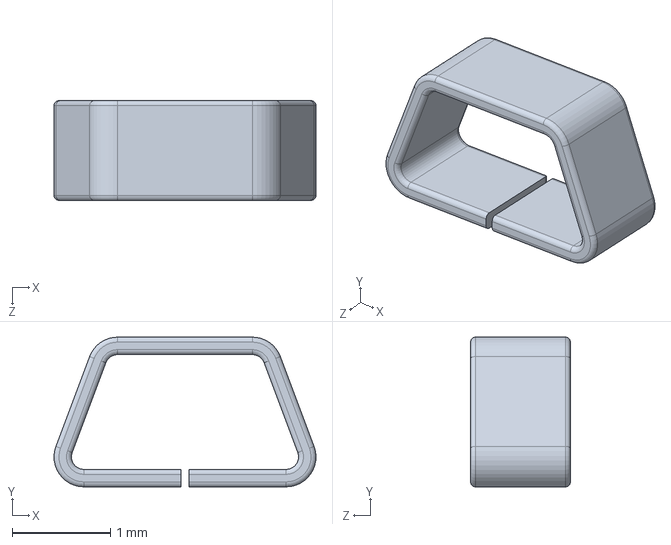
[picture p58: CAD file, 2021-04-10]
aj_packages3d/3D/Test_Points/CAD/TEST_POINT_SMT_KEYSTONE_5015.SLDPRT
2.67 x 1.52 x 1.02 mm
