promesoft/KicadJE_LIB/aj_packages3d/3D/Battery_Holders/STEP/keystone-PN2462.STEP

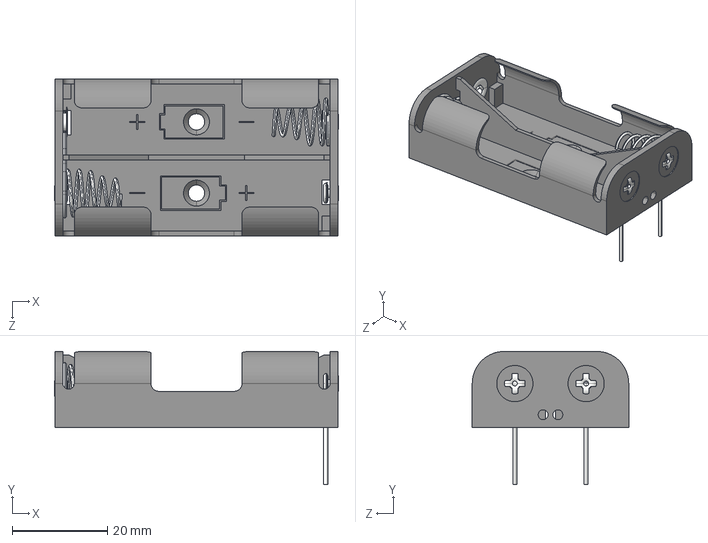
[picture p59: CAD file, 2021-04-10]
aj_packages3d/3D/Battery_Holders/STEP/keystone-PN2462.STEP
59.7 x 28.0 x 32.9 mm
