promesoft/KicadJE_LIB/aj_packages3d/3D/Connectors/JST/STEP/BM06B-SRSS-TB.step

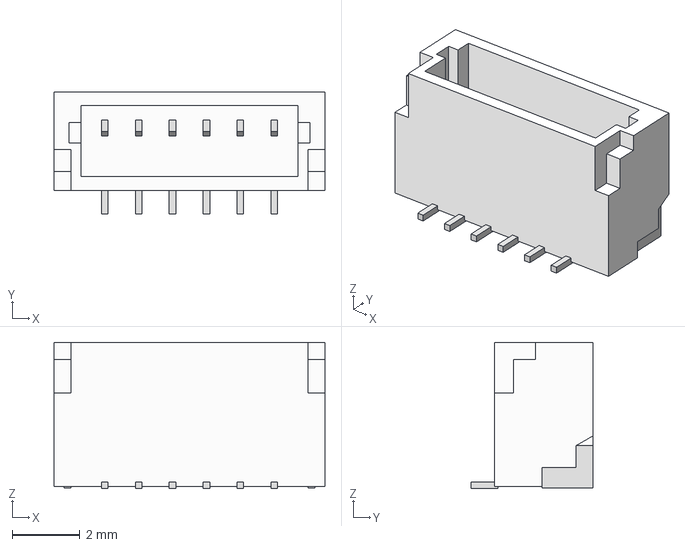
[picture p60: CAD file, 2021-04-10]
aj_packages3d/3D/Connectors/JST/STEP/BM06B-SRSS-TB.step
8.00 x 3.60 x 4.32 mm
