promesoft/KicadJE_LIB/aj_packages3d/3D/Discrete/Active/STEP/SOD-323F.step

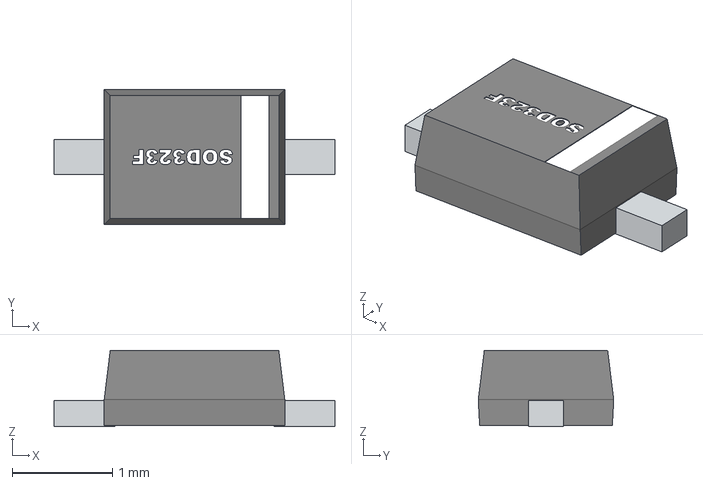
[picture p61: CAD file, 2021-04-10]
aj_packages3d/3D/Discrete/Active/STEP/SOD-323F.step
2.80 x 1.35 x 0.76 mm
