promesoft/KicadJE_LIB/aj_packages3d/3D/Discrete/Passive/Capacitors/STEP/C0603.step

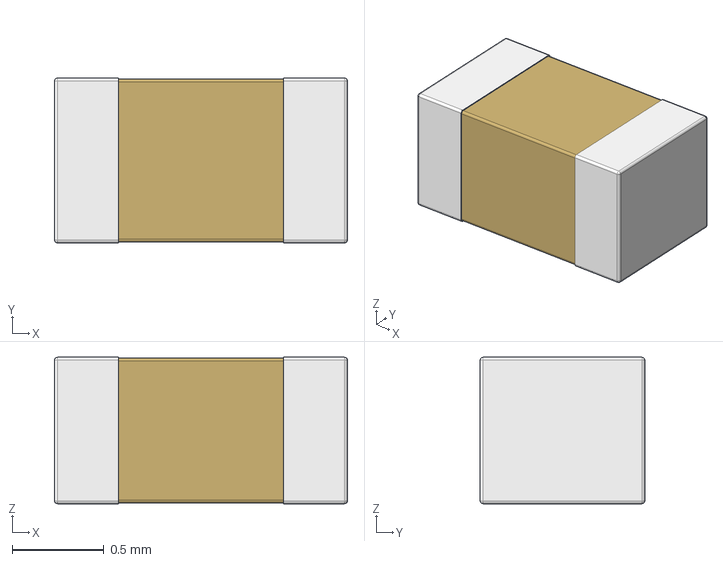
[picture p62: CAD file, 2021-04-10]
aj_packages3d/3D/Discrete/Passive/Capacitors/STEP/C0603.step
1.60 x 0.9 x 0.8 mm
