promesoft/KicadJE_LIB/aj_packages3d/3D/Discrete/Passive/Inductors/STEP/SRN6045.step

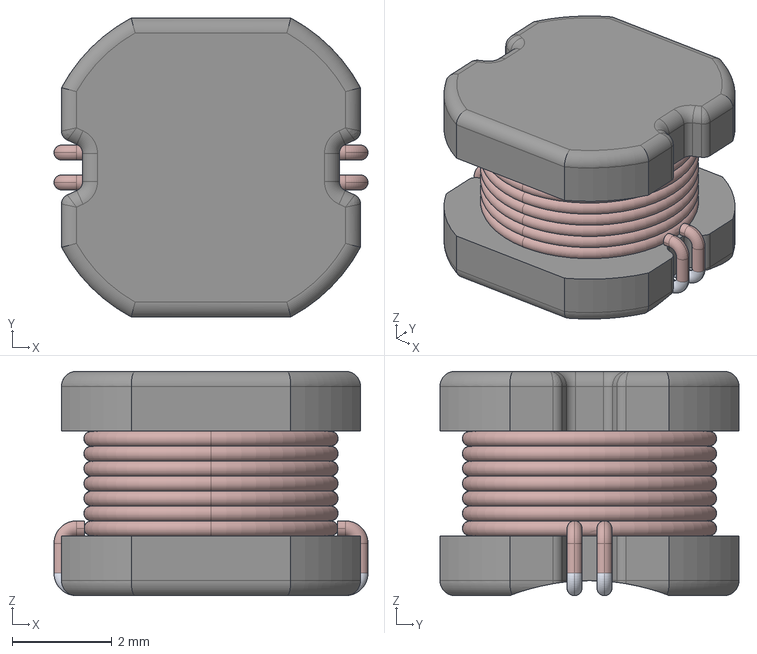
[picture p63: CAD file, 2021-04-10]
aj_packages3d/3D/Discrete/Passive/Inductors/STEP/SRN6045.step
6.30 x 6.00 x 4.50 mm
