promesoft/KicadJE_LIB/aj_packages3d/3D/Discrete/Passive/Resistors/STEP/R0603.step

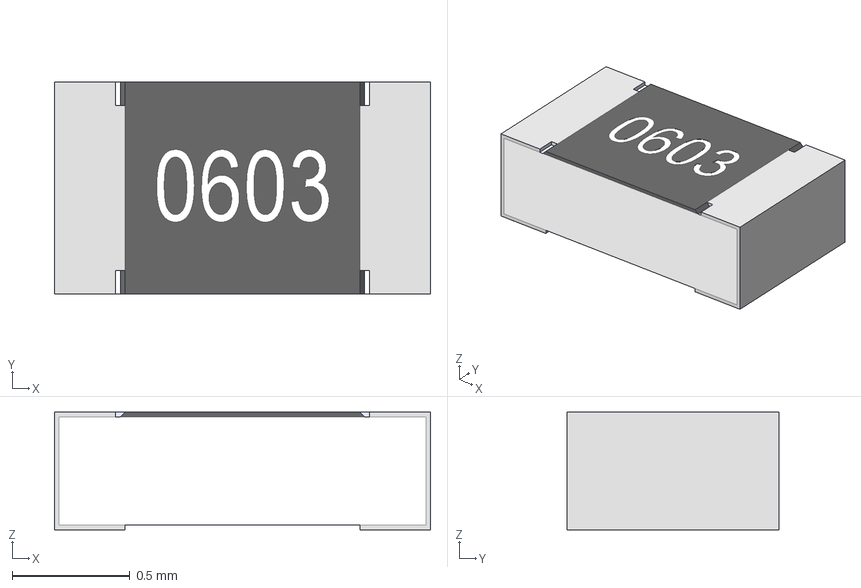
[picture p64: CAD file, 2021-04-10]
aj_packages3d/3D/Discrete/Passive/Resistors/STEP/R0603.step
1.60 x 0.9 x 0.5 mm
