promesoft/KicadJE_LIB/aj_packages3d/3D/Headers/STEP/Harwin_M20-7820546.step

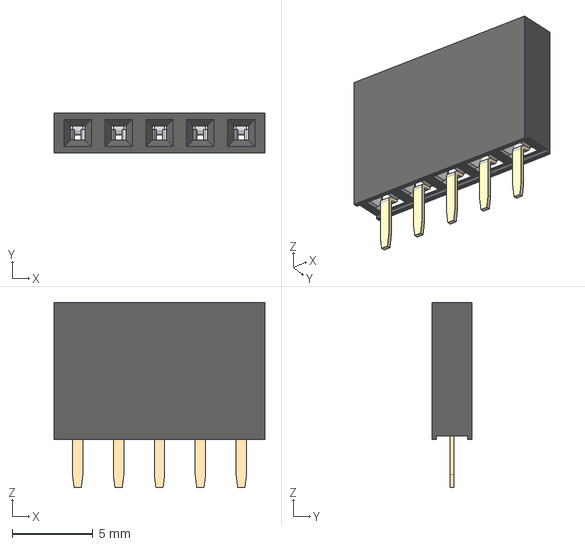
[picture p66: CAD file, 2021-04-10]
aj_packages3d/3D/Headers/STEP/Harwin_M20-7820546.step
13.1 x 2.50 x 11.5 mm
