promesoft/KicadJE_LIB/aj_packages3d/3D/ICs/SOT/STEP/SOT-143.step

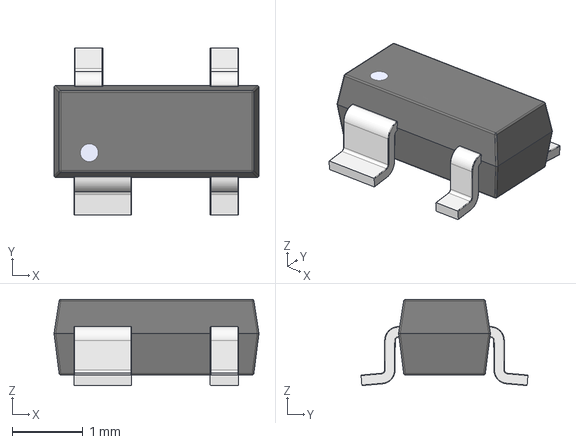
[picture p67: CAD file, 2021-04-10]
aj_packages3d/3D/ICs/SOT/STEP/SOT-143.step
2.90 x 2.36 x 1.22 mm
