promesoft/KicadJE_LIB/aj_packages3d/3D/RF_Modules/STEP/ESP-03.STEP

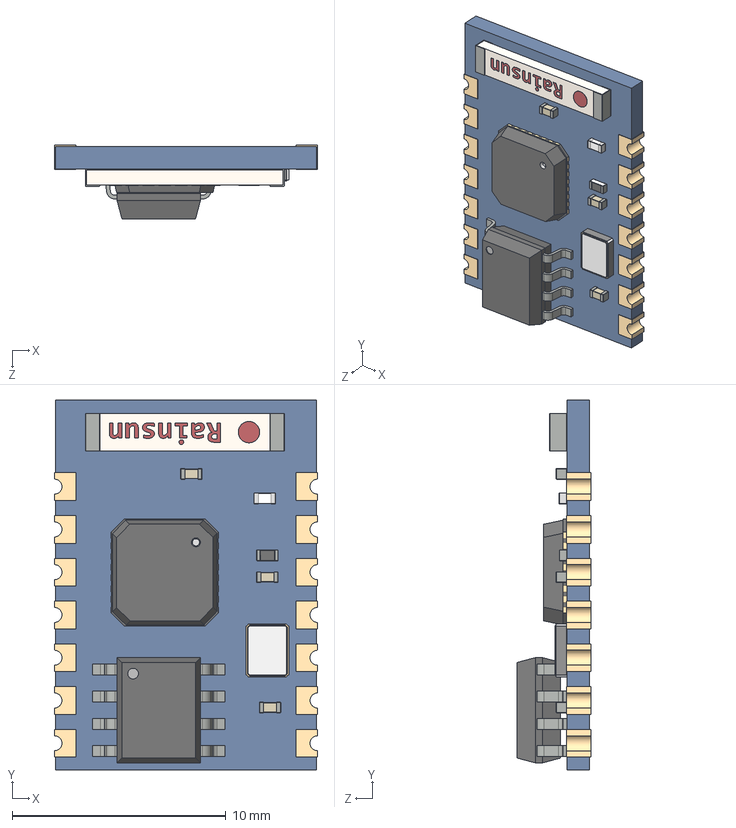
[picture p68: CAD file, 2021-04-10]
aj_packages3d/3D/RF_Modules/STEP/ESP-03.STEP
12.3 x 17.3 x 3.44 mm
User Library-ESP-03_Board
User Library-ESP-03_AN9520_small
User Library-ESP-03_SW3dPS-inductor_0402_white
User Library-ESP-03_User_Library-SOIC-8-150_2
User Library-ESP-03_User_Library-CRY_2520_
User Library-ESP-03_Cap0402 x 3
User Library-ESP-03_Res0402
User Library-ESP-03_QFN32
User Library-ESP-03_Goldcontact x 14
