promesoft/KicadJE_LIB/aj_packages3d/3D/Terminal_Blocks/STEP/OSTVN02A150.STEP

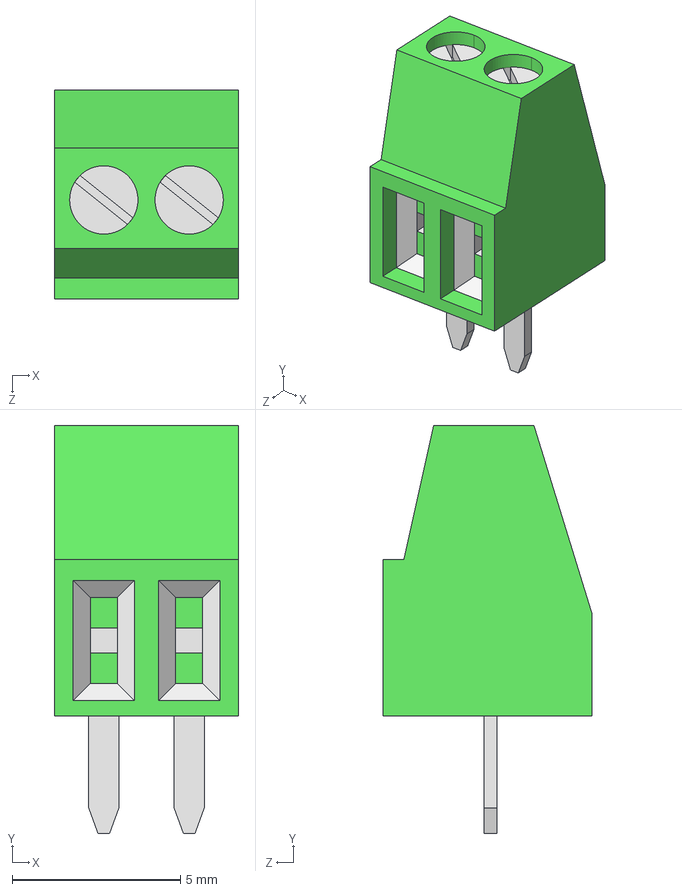
[picture p69: CAD file, 2021-04-10]
aj_packages3d/3D/Terminal_Blocks/STEP/OSTVN02A150.STEP
5.48 x 12.1 x 6.22 mm
