promesoft/KicadJE_LIB/aj_packages3d/3D/Test_Points/CAD/TEST_POINT_PTH_KEYSTONE_5011.SLDPRT

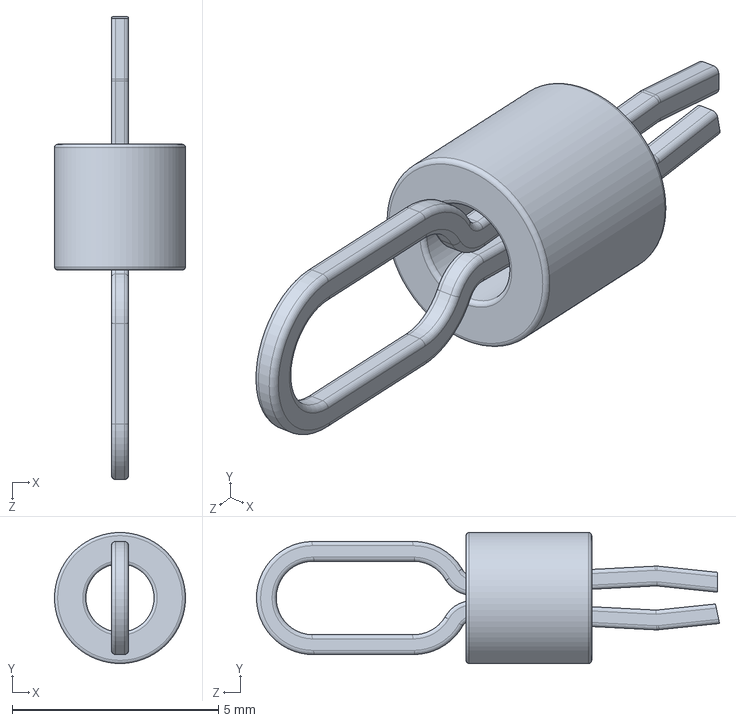
[picture p70: CAD file, 2021-04-10]
aj_packages3d/3D/Test_Points/CAD/TEST_POINT_PTH_KEYSTONE_5011.SLDPRT
3.17 x 3.17 x 11.2 mm
