promesoft/KicadJE_LIB/aj_packages3d/3D/Battery_Holders/STEP/BHCL.STEP

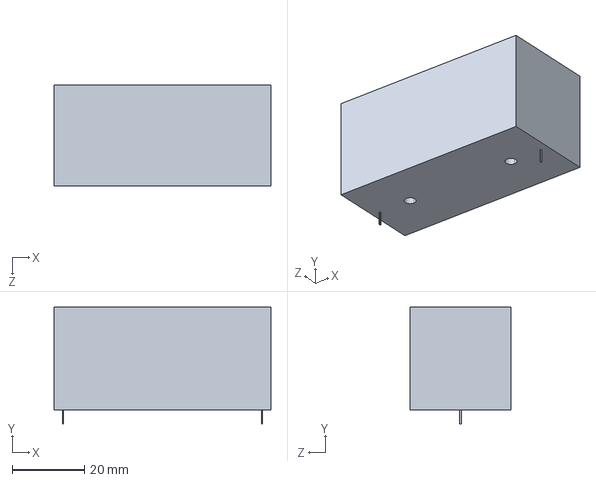
[picture p71: CAD file, 2021-04-10]
aj_packages3d/3D/Battery_Holders/STEP/BHCL.STEP
60.1 x 32.3 x 28.1 mm
