promesoft/KicadJE_LIB/aj_packages3d/3D/Connectors/JST/STEP/B6B-PH-K-S.step

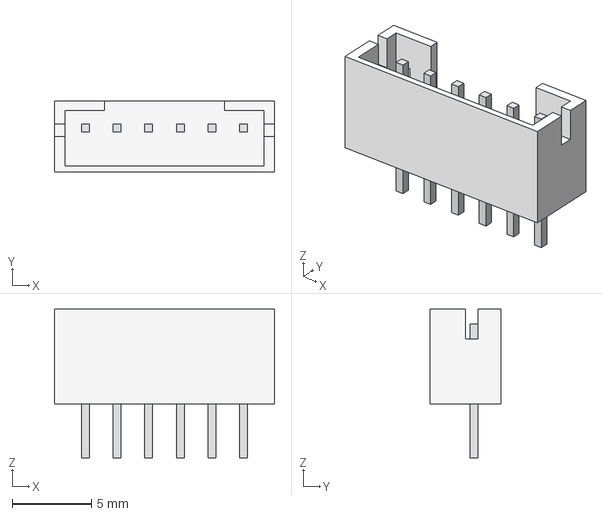
[picture p72: CAD file, 2021-04-10]
aj_packages3d/3D/Connectors/JST/STEP/B6B-PH-K-S.step
13.9 x 4.50 x 9.40 mm
