promesoft/KicadJE_LIB/aj_packages3d/3D/Discrete/Passive/Capacitors/STEP/C0805.step

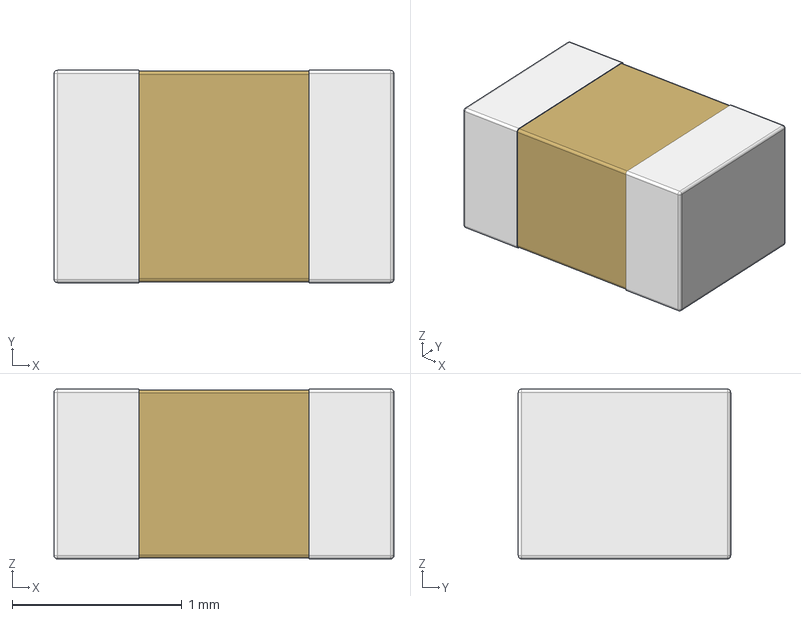
[picture p73: CAD file, 2021-04-10]
aj_packages3d/3D/Discrete/Passive/Capacitors/STEP/C0805.step
2.00 x 1.25 x 1.00 mm
