promesoft/KicadJE_LIB/aj_packages3d/3D/Discrete/Passive/Resistors/STEP/R0402.step

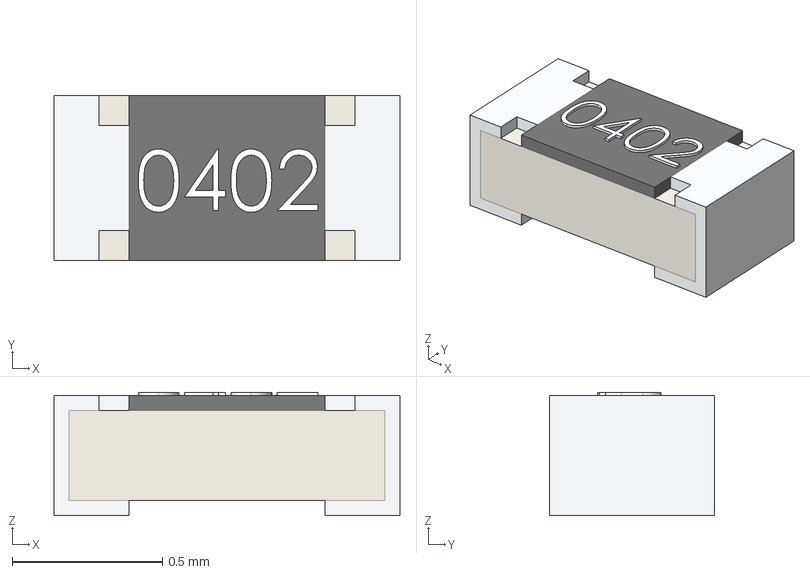
[picture p74: CAD file, 2021-04-10]
aj_packages3d/3D/Discrete/Passive/Resistors/STEP/R0402.step
1.15 x 0.55 x 0.41 mm
