promesoft/KicadJE_LIB/aj_packages3d/3D/ICs/SOT/STEP/SOT-89.step

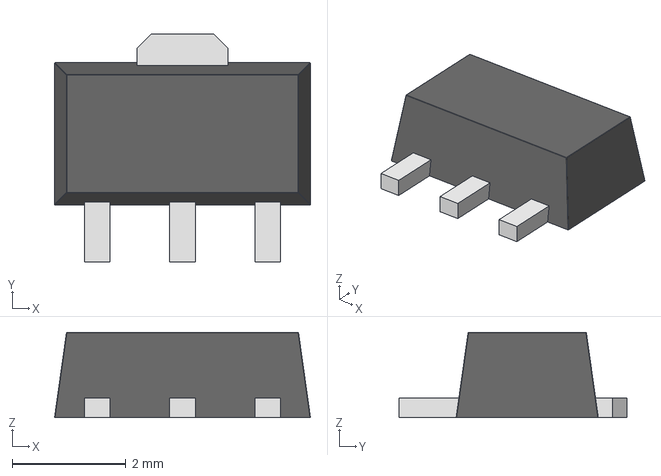
[picture p75: CAD file, 2021-04-10]
aj_packages3d/3D/ICs/SOT/STEP/SOT-89.step
4.50 x 4.00 x 1.50 mm
