promesoft/KicadJE_LIB/aj_packages3d/3D/RF_Modules/STEP/RFM12.STEP

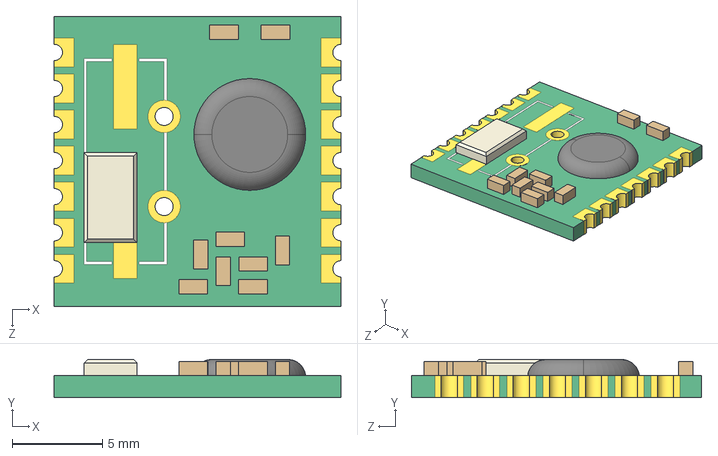
[picture p76: CAD file, 2021-04-10]
aj_packages3d/3D/RF_Modules/STEP/RFM12.STEP
15.9 x 2.11 x 16.1 mm
