promesoft/KicadJE_LIB/aj_packages3d/3D/RF_Modules/STL/ESP-07v2_4wings.stl

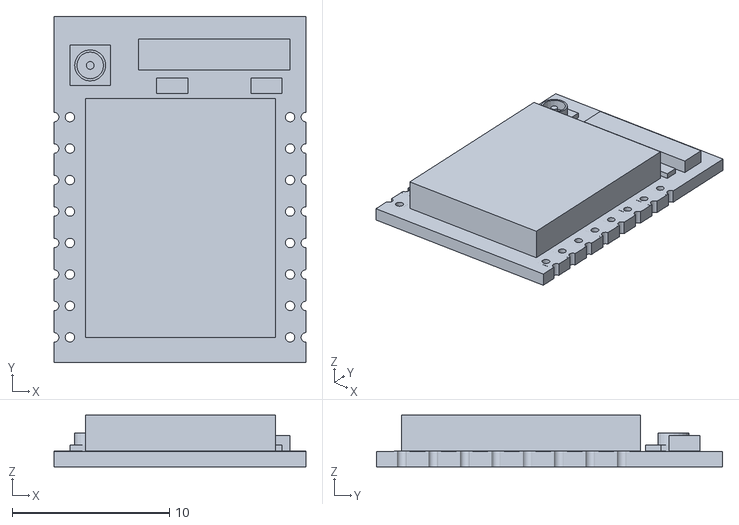
[picture p77: CAD file, 2021-04-10]
aj_packages3d/3D/RF_Modules/STL/ESP-07v2_4wings.stl
16.0 x 22.0 x 3.30
