promesoft/KicadJE_LIB/aj_packages3d/3D/Battery_Holders/STEP/BHC-2_CELL.STEP

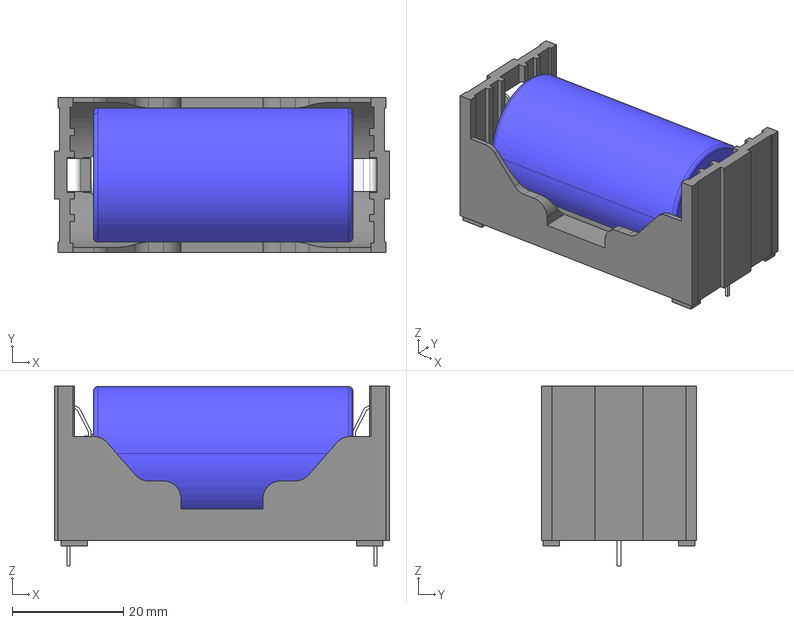
[picture p78: CAD file, 2021-04-10]
aj_packages3d/3D/Battery_Holders/STEP/BHC-2_CELL.STEP
60.2 x 27.9 x 32.3 mm
