promesoft/KicadJE_LIB/aj_packages3d/3D/Discrete/Passive/Capacitors/STEP/C1206.step

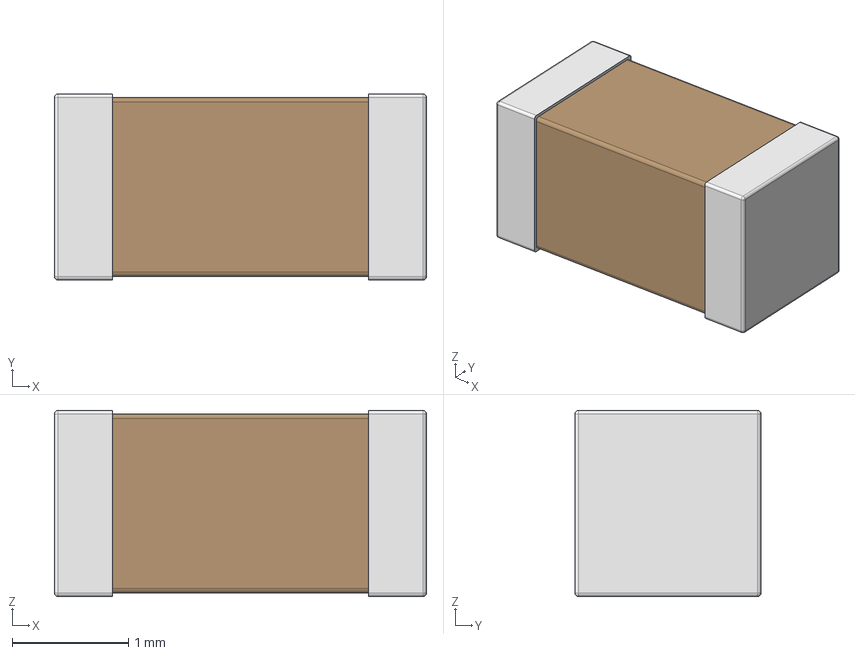
[picture p79: CAD file, 2021-04-10]
aj_packages3d/3D/Discrete/Passive/Capacitors/STEP/C1206.step
3.20 x 1.60 x 1.60 mm
