promesoft/KicadJE_LIB/aj_packages3d/3D/Headers/STEP/HEADER_F_2.54MM_1R3P_ST_AU_PTH.step

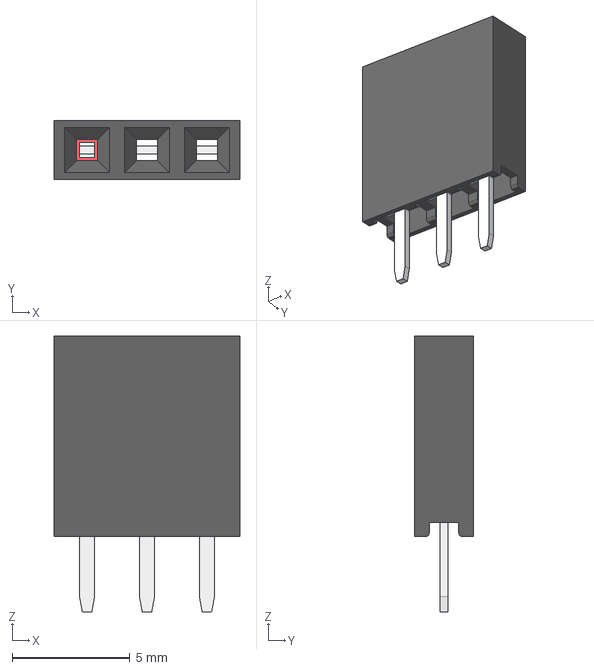
[picture p80: CAD file, 2021-04-10]
aj_packages3d/3D/Headers/STEP/HEADER_F_2.54MM_1R3P_ST_AU_PTH.step
7.87 x 2.50 x 11.7 mm
