promesoft/KicadJE_LIB/aj_packages3d/3D/RF_Modules/STEP/Raytac-MDBT40.step

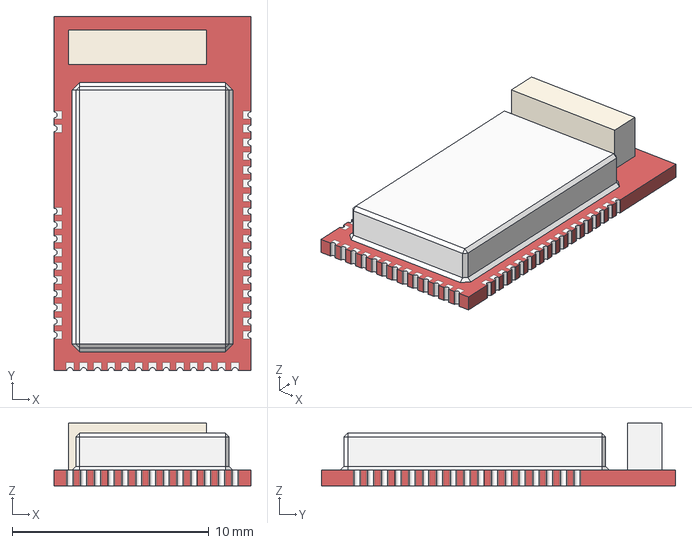
[picture p82: CAD file, 2021-04-10]
aj_packages3d/3D/RF_Modules/STEP/Raytac-MDBT40.step
10.0 x 18.0 x 3.20 mm
