promesoft/KicadJE_LIB/aj_packages3d/3D/Terminal_Blocks/STEP/TB_5.08MM_1R2P_HORZ_2PC_SCRW_PTH.step

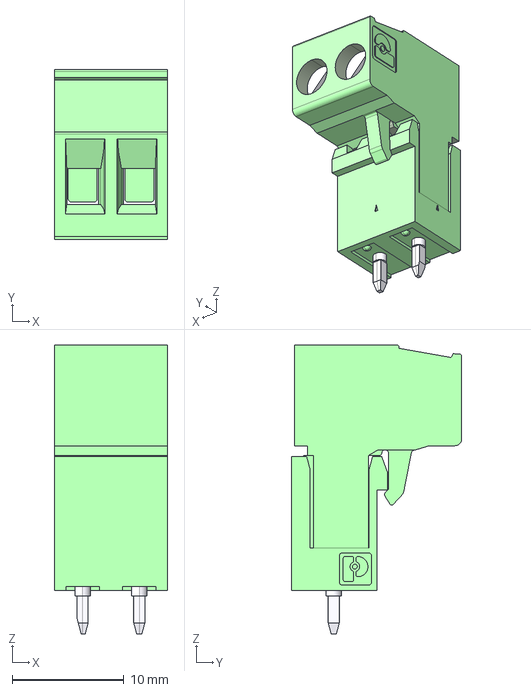
[picture p83: CAD file, 2021-04-10]
aj_packages3d/3D/Terminal_Blocks/STEP/TB_5.08MM_1R2P_HORZ_2PC_SCRW_PTH.step
10.2 x 15.3 x 25.9 mm
