promesoft/KicadJE_LIB/aj_packages3d/3D/Discrete/Passive/Capacitors/STEP/CAP_8X10MM_SMT.step

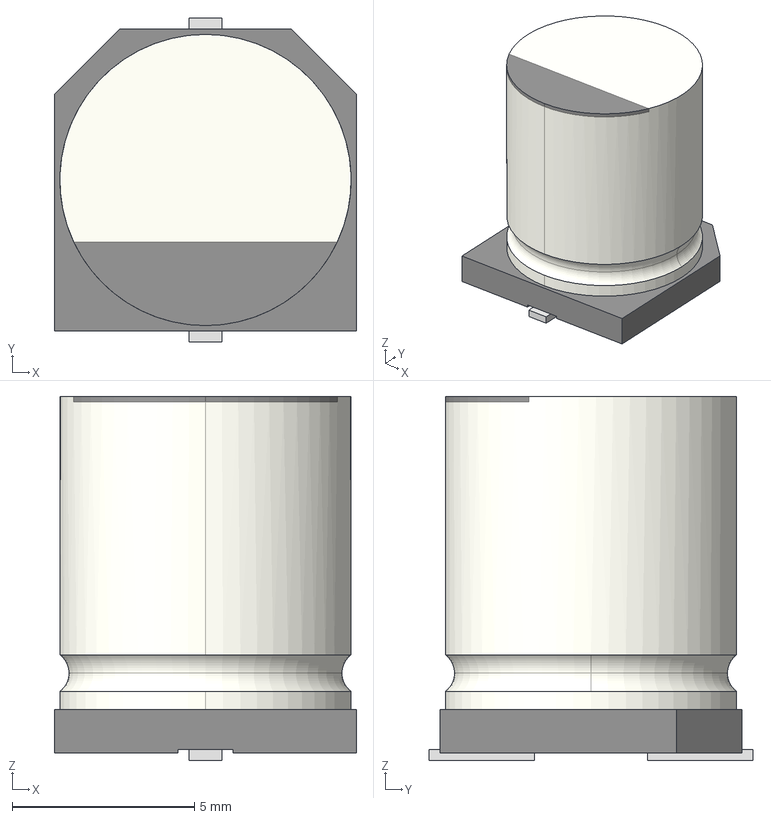
[picture p84: CAD file, 2021-04-10]
aj_packages3d/3D/Discrete/Passive/Capacitors/STEP/CAP_8X10MM_SMT.step
8.30 x 8.90 x 10.0 mm
