promesoft/KicadJE_LIB/aj_packages3d/3D/Headers/STEP/HEADER_M_1.27MM_2R10P_ST_AU_PTH.step

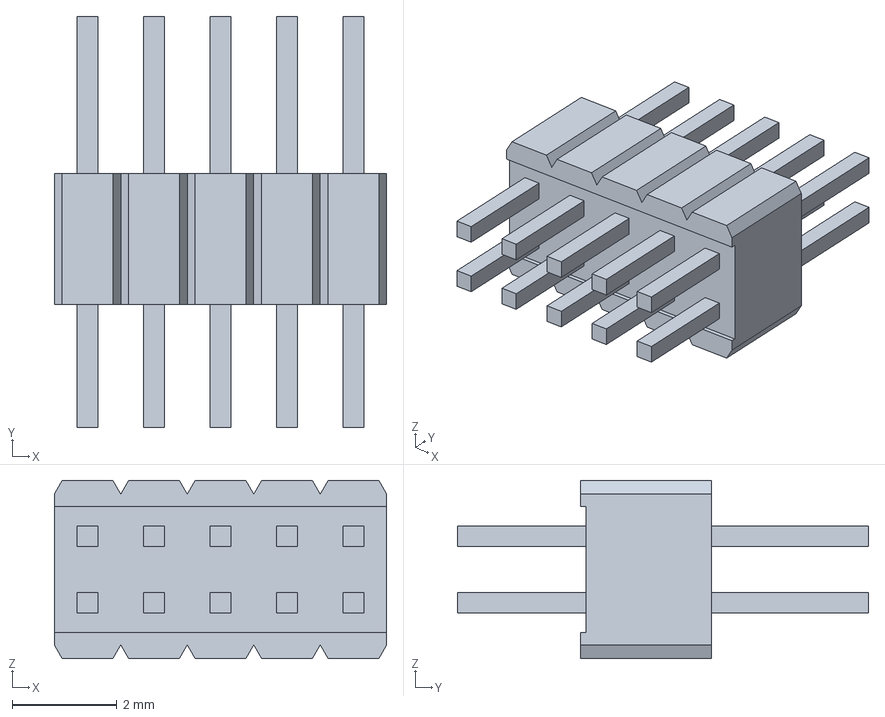
[picture p85: CAD file, 2021-04-10]
aj_packages3d/3D/Headers/STEP/HEADER_M_1.27MM_2R10P_ST_AU_PTH.step
6.35 x 7.85 x 3.40 mm
