promesoft/KicadJE_LIB/aj_packages3d/3D/ICs/SOT/STEP/SOT-23-3.step

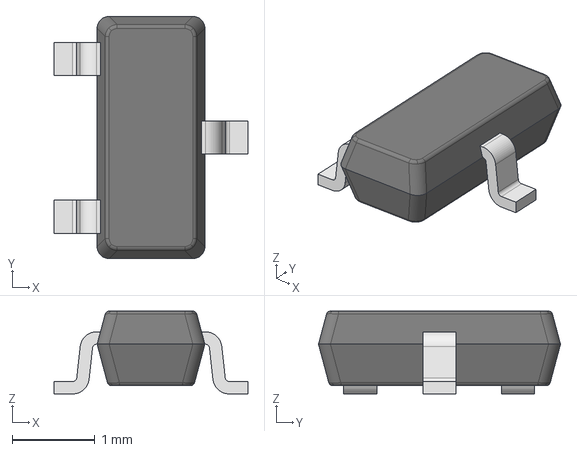
[picture p86: CAD file, 2021-04-10]
aj_packages3d/3D/ICs/SOT/STEP/SOT-23-3.step
2.34 x 2.92 x 1.00 mm
