promesoft/KicadJE_LIB/aj_packages3d/3D/Headers/STEP/HEADER_M_2.00MM_1R10P_ST_AU_PTH_XBEE_P11_P20.step

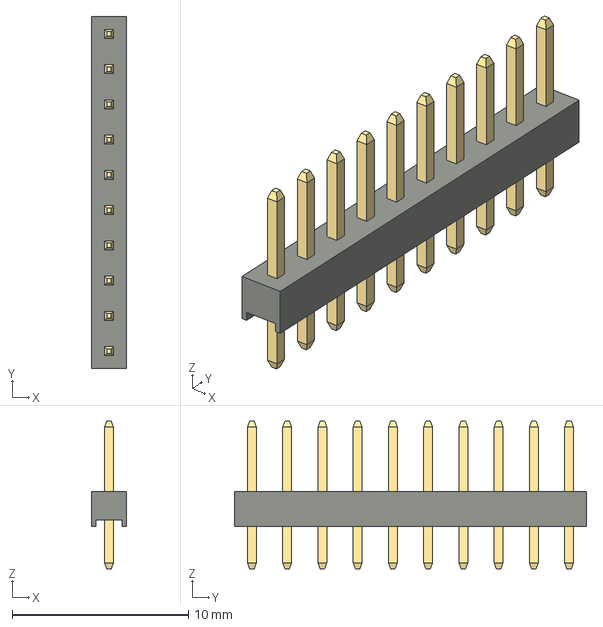
[picture p88: CAD file, 2021-04-10]
aj_packages3d/3D/Headers/STEP/HEADER_M_2.00MM_1R10P_ST_AU_PTH_XBEE_P11_P20.step
2.00 x 20.0 x 8.40 mm
