promesoft/KicadJE_LIB/aj_packages3d/3D/ICs/SOT/STEP/SOT-223.step

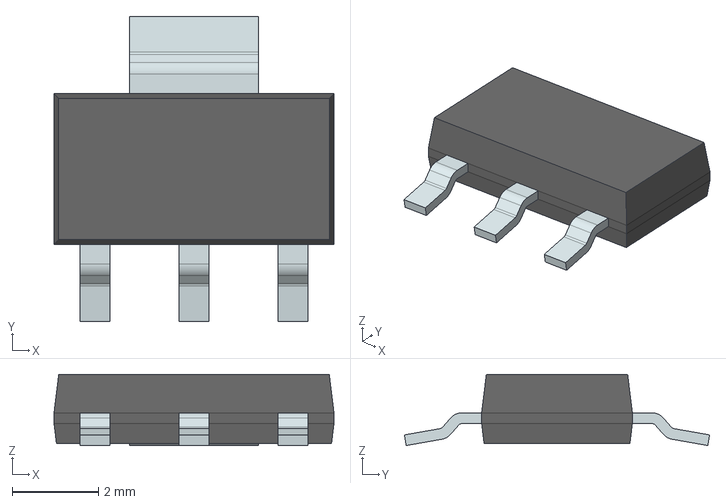
[picture p89: CAD file, 2021-04-10]
aj_packages3d/3D/ICs/SOT/STEP/SOT-223.step
6.50 x 7.09 x 1.65 mm
