promesoft/KicadJE_LIB/aj_packages3d/3D/Terminal_Blocks/STEP/TB_3.50MM_1R2P_HORZ_2PC_SCRW_PTH.step

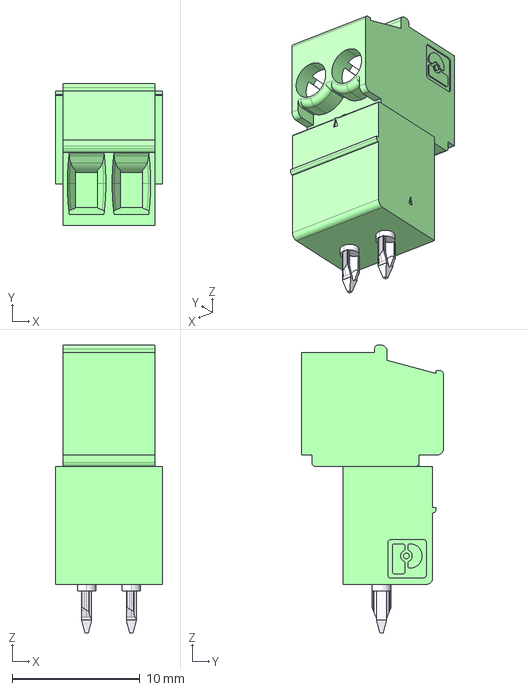
[picture p90: CAD file, 2021-04-10]
aj_packages3d/3D/Terminal_Blocks/STEP/TB_3.50MM_1R2P_HORZ_2PC_SCRW_PTH.step
8.40 x 11.1 x 22.5 mm
