promesoft/KicadJE_LIB/aj_packages3d/3D/Headers/STEP/HEADER_M_2.54MM_1R8P_0.230H_ST_AU_SMT.step

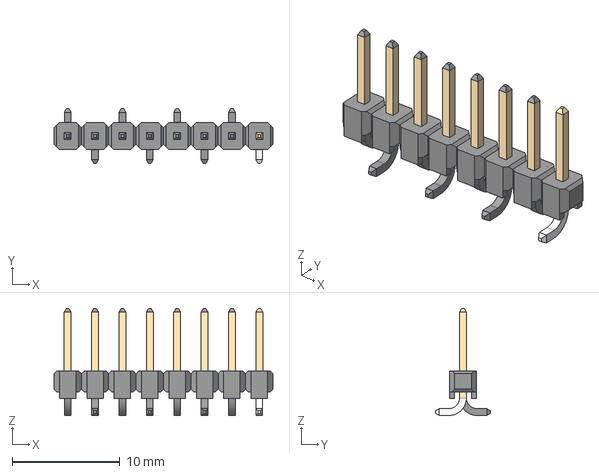
[picture p91: CAD file, 2021-04-10]
aj_packages3d/3D/Headers/STEP/HEADER_M_2.54MM_1R8P_0.230H_ST_AU_SMT.step
20.3 x 5.08 x 9.93 mm
