promesoft/KicadJE_LIB/aj_packages3d/3D/ICs/SOT/STEP/SOT-353.step

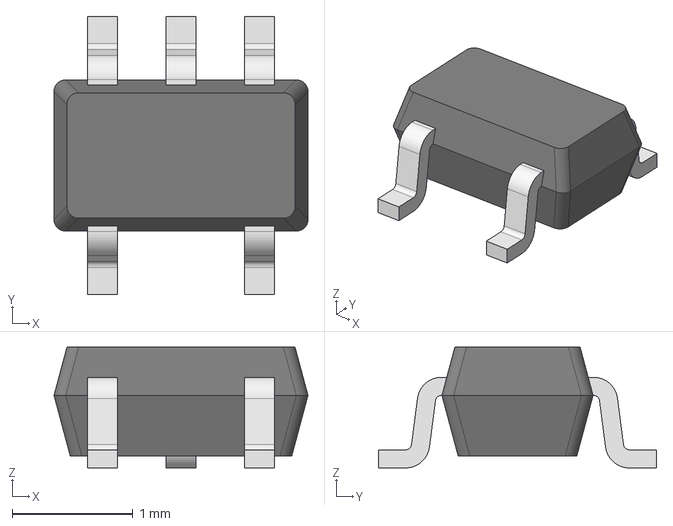
[picture p92: CAD file, 2021-04-10]
aj_packages3d/3D/ICs/SOT/STEP/SOT-353.step
2.10 x 2.30 x 1.00 mm
