promesoft/KicadJE_LIB/aj_packages3d/3D/Terminal_Blocks/STEP/TB_3.5MM_1R2P_HORZ_PTH_2PC_PLUG.STEP

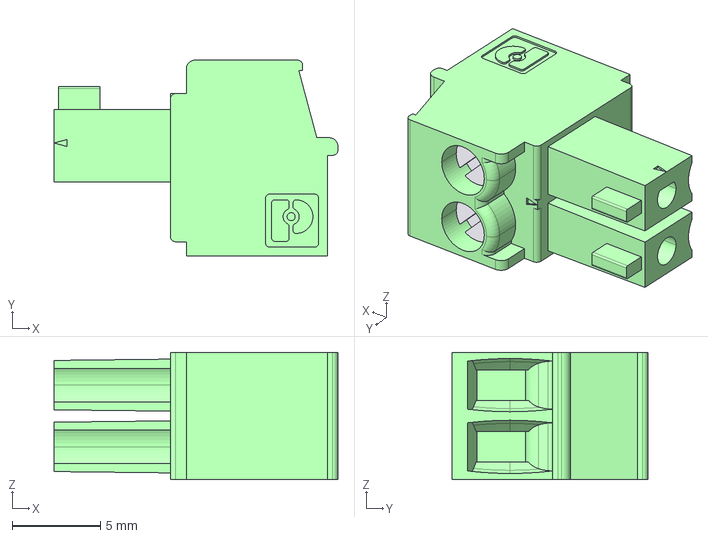
[picture p93: CAD file, 2021-04-10]
aj_packages3d/3D/Terminal_Blocks/STEP/TB_3.5MM_1R2P_HORZ_PTH_2PC_PLUG.STEP
16.1 x 11.1 x 7.20 mm
