promesoft/KicadJE_LIB/aj_packages3d/3D/ICs/SOT/STEP/SOT-23-5.step

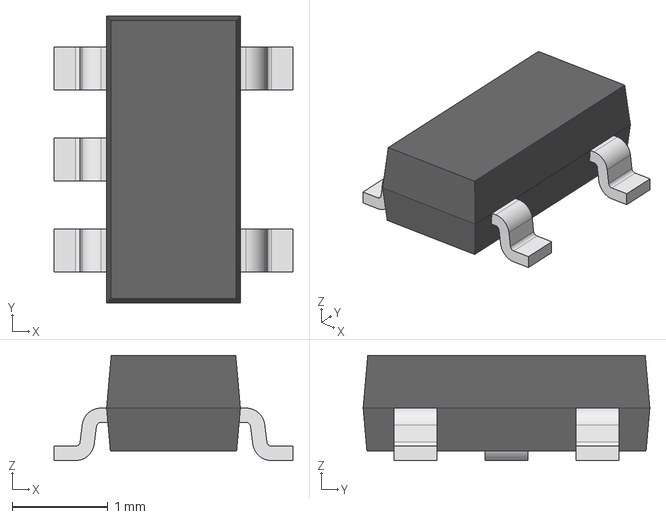
[picture p95: CAD file, 2021-04-10]
aj_packages3d/3D/ICs/SOT/STEP/SOT-23-5.step
2.50 x 3.00 x 1.10 mm
