promesoft/KicadJE_LIB/aj_packages3d/3D/Terminal_Blocks/STEP/OSTVN10A150.STEP

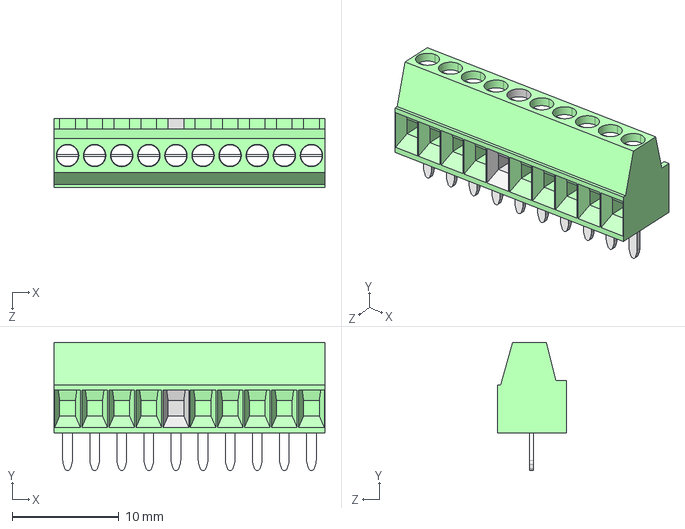
[picture p96: CAD file, 2021-04-10]
aj_packages3d/3D/Terminal_Blocks/STEP/OSTVN10A150.STEP
25.4 x 12.0 x 6.50 mm
