promesoft/KicadJE_LIB/aj_packages3d/3D/Headers/STEP/HEADER_M_2.54MM_1R10P_0.230H_ST_AU_SMT.step

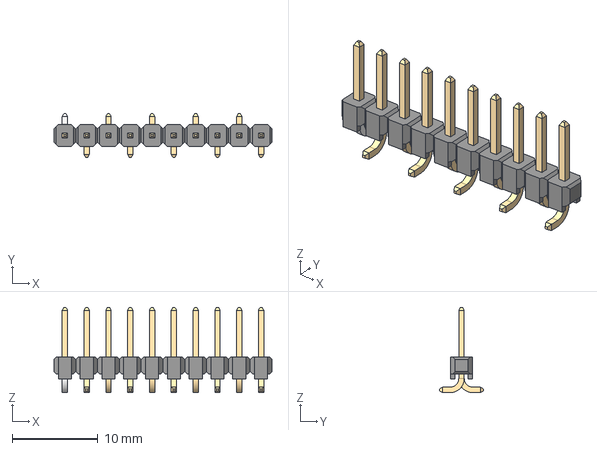
[picture p97: CAD file, 2021-04-10]
aj_packages3d/3D/Headers/STEP/HEADER_M_2.54MM_1R10P_0.230H_ST_AU_SMT.step
25.4 x 5.08 x 9.93 mm
