promesoft/KicadJE_LIB/aj_packages3d/3D/Terminal_Blocks/STEP/OSTTC022162.STEP

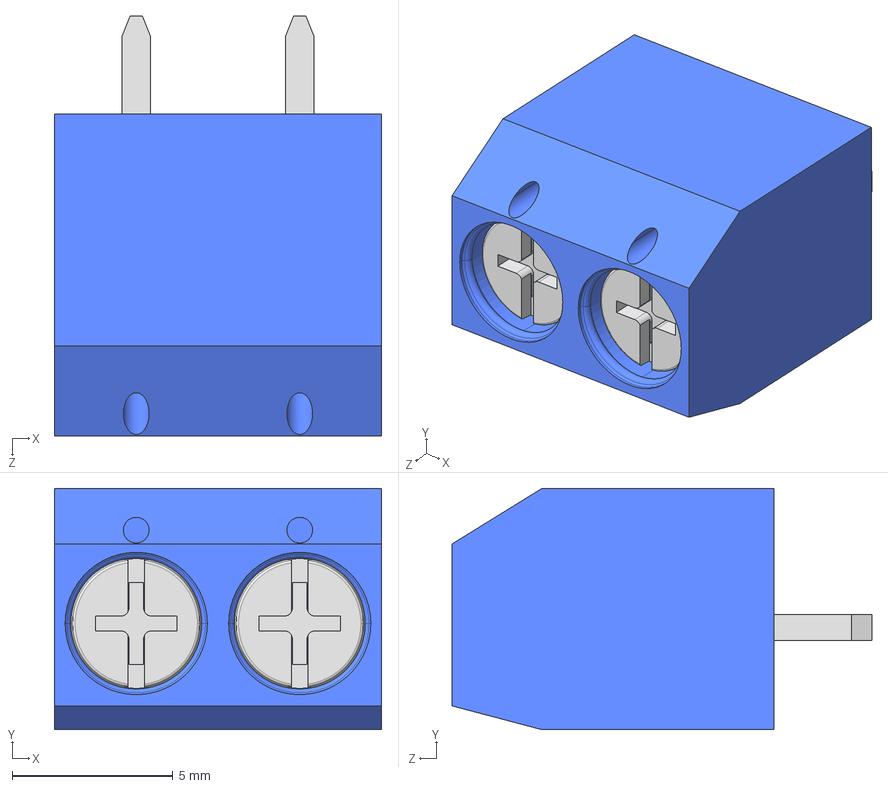
[picture p98: CAD file, 2021-04-10]
aj_packages3d/3D/Terminal_Blocks/STEP/OSTTC022162.STEP
10.2 x 7.50 x 13.0 mm
User Library-Terminal block 2 POS_395443002
User Library-Terminal block 2 POS__155
User Library-Terminal block 2 POS__532
User Library-Terminal block 2 POS__752
User Library-Terminal block 2 POS_395443002_2
