promesoft/KicadJE_LIB/aj_packages3d/3D/Terminal_Blocks/STEP/TB_5.08MM_1R2P_HORZ_PTH_2PC_SOCKET.STEP

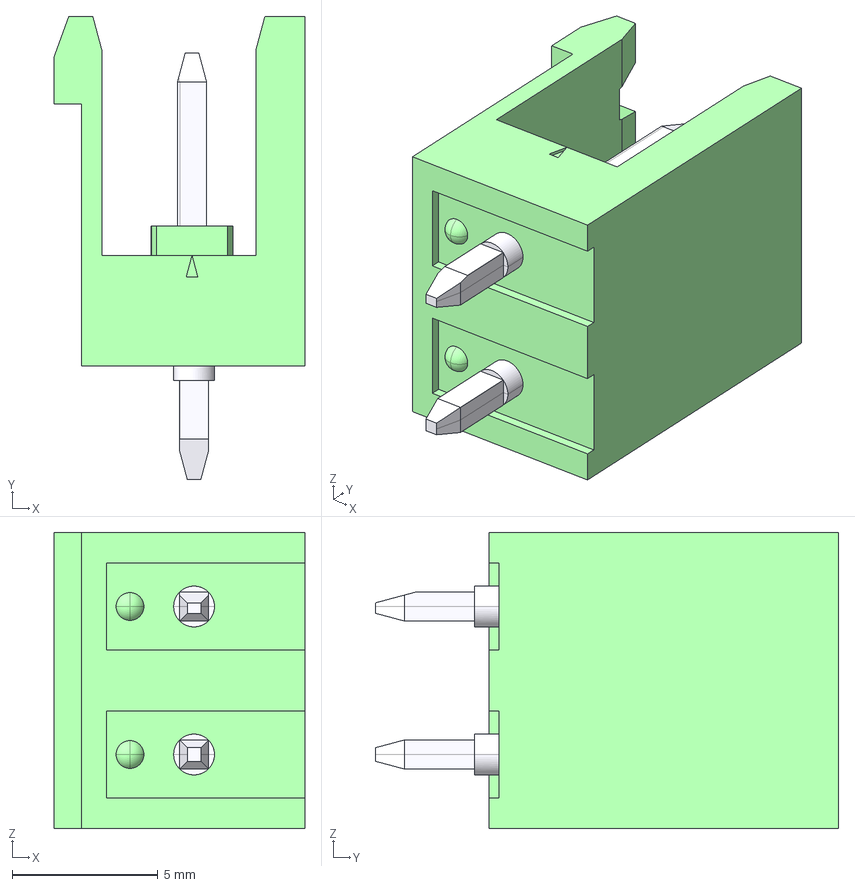
[picture p102: CAD file, 2021-04-10]
aj_packages3d/3D/Terminal_Blocks/STEP/TB_5.08MM_1R2P_HORZ_PTH_2PC_SOCKET.STEP
8.60 x 15.9 x 10.2 mm
