promesoft/KicadJE_LIB/aj_packages3d/3D/Headers/STEP/HEADER_F_2.54MM_1R6P_ST_AU_PTH.step

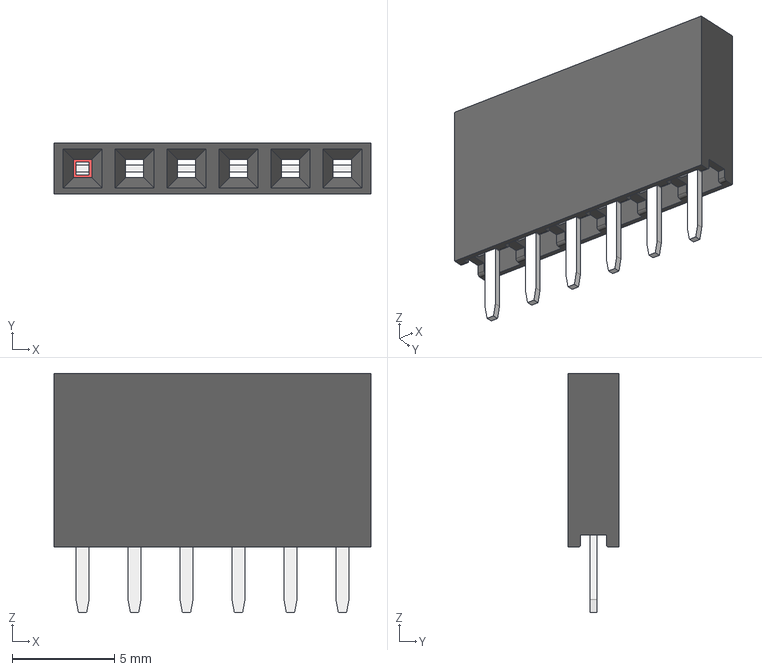
[picture p103: CAD file, 2021-04-10]
aj_packages3d/3D/Headers/STEP/HEADER_F_2.54MM_1R6P_ST_AU_PTH.step
15.5 x 2.50 x 11.7 mm
