promesoft/KicadJE_LIB/aj_packages3d/3D/Headers/STEP/HEADER_M_1.27MMx2.54MM_2R10P_ST_AU_SMT.step

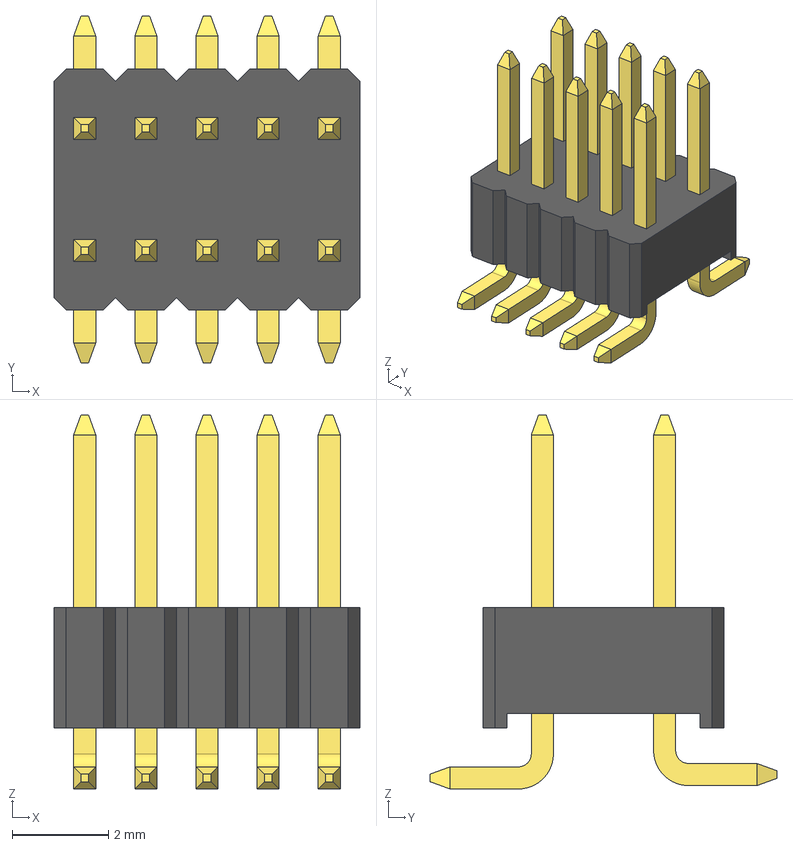
[picture p104: CAD file, 2021-04-10]
aj_packages3d/3D/Headers/STEP/HEADER_M_1.27MMx2.54MM_2R10P_ST_AU_SMT.step
6.35 x 7.20 x 7.77 mm
