promesoft/KicadJE_LIB/aj_packages3d/3D/Headers/STEP/HEADER_M_2.54MM_2R6P_0.230H_0.120T_ST_AU_PTH.step

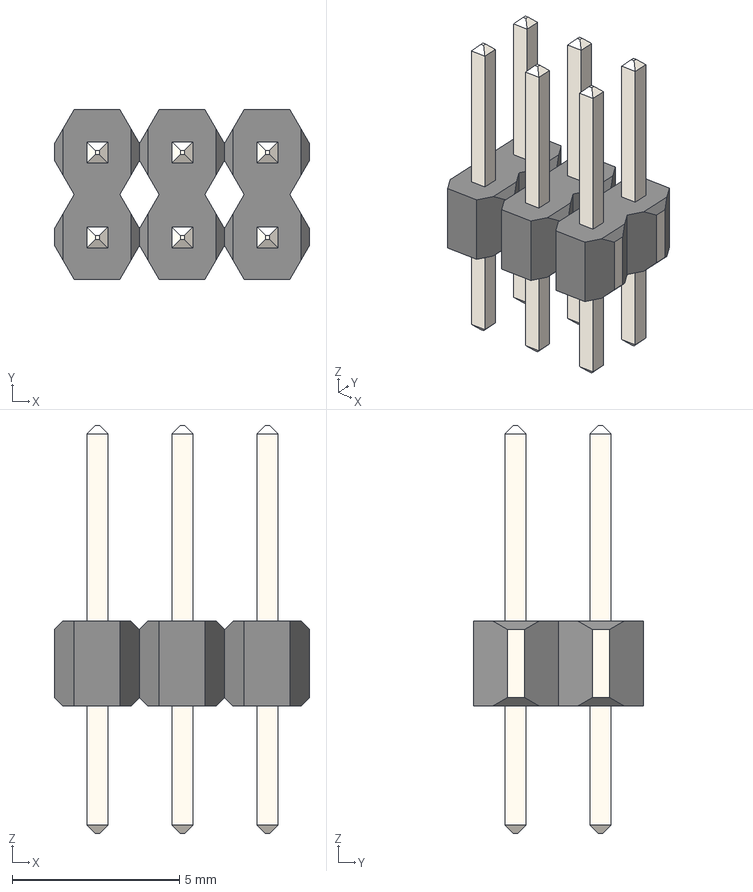
[picture p105: CAD file, 2021-04-10]
aj_packages3d/3D/Headers/STEP/HEADER_M_2.54MM_2R6P_0.230H_0.120T_ST_AU_PTH.step
7.62 x 5.08 x 12.2 mm
