promesoft/KicadJE_LIB/aj_packages3d/3D/Headers/STEP/Harwin_M20-7820246.step

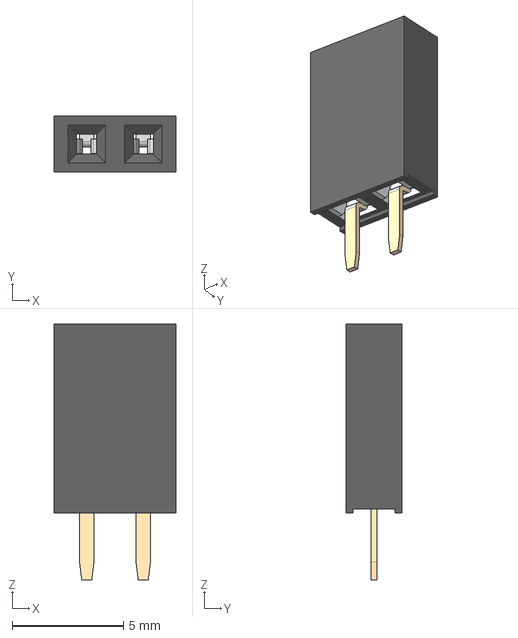
[picture p107: CAD file, 2021-04-10]
aj_packages3d/3D/Headers/STEP/Harwin_M20-7820246.step
5.48 x 2.50 x 11.5 mm
