promesoft/KicadJE_LIB/aj_packages3d/3D/Headers/STEP/HEADER_F_2.54MM_1R8P_ST_AU_PTH.step

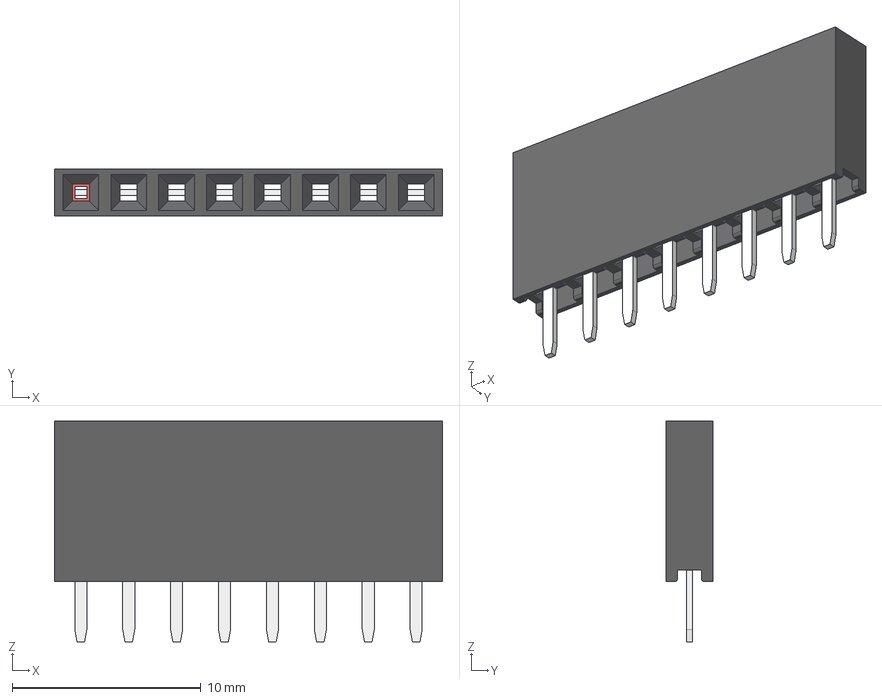
[picture p109: CAD file, 2021-04-10]
aj_packages3d/3D/Headers/STEP/HEADER_F_2.54MM_1R8P_ST_AU_PTH.step
20.6 x 2.50 x 11.7 mm
