promesoft/KicadJE_LIB/(list of files, cad)

Other CAD files:
aj_packages3d/3D/Connectors/RF/STEP/UFL-R-SMT_ALT.step
aj_packages3d/3D/Electromechanical/Relays/STEP/T9AS1D12.stp
aj_packages3d/3D/ICs/SOIC/STEP/SOIC-8E.step
aj_packages3d/3D/RF_Modules/STL/ESP-12.stl
aj_packages3d/3D/Terminal_Blocks/CAD/User Library-Connector-8.SLDPRT
aj_packages3d/3D/Electromechanical/Relays/STEP/T9AS1D2.step
aj_packages3d/3D/Terminal_Blocks/STEP/Phoneix_1985250.STEP
aj_packages3d/3D/Electromechanical/Relays/STEP/T9AS1D22.stp
aj_packages3d/3D/RF_Modules/STL/ESP-13-wroom-02.stl
aj_packages3d/3D/Electromechanical/Relays/STEP/T9AS5D2.step
aj_packages3d/3D/RF_Modules/STL/ESP-07v2.stl
aj_packages3d/3D/Electromechanical/Relays/STEP/T9AS1D1.step
aj_packages3d/3D/Electromechanical/Relays/STEP/T9AS5D1.step
aj_packages3d/3D/ICs/SOT/STEP/SOT-143B.step
aj_packages3d/3D/Headers/STEP/HEADER_M_2.00MM_1R10P_ST_AU_PTH_XBEE_P1_P10.step
aj_packages3d/3D/RF_Modules/CAD/ESP-07v2.scad
aj_packages3d/3D/RF_Modules/CAD/ESP-12.scad
aj_packages3d/3D/RF_Modules/CAD/ESP-13-wroom-02.scad
aj_packages3d/3D/Connectors/SD/STEP/475710001.stp
aj_packages3d/3D/Modules/CAD/Arduino_Pro_Mini.SLDPRT
aj_packages3d/3D/Modules/STL/Arduino_Pro_Mini.STL
aj_packages3d/3D/Power_Supplies/AC_DC_Converters/CAD/HiLink_HLK-PM03.SLDPRT
aj_packages3d/3D/Power_Supplies/AC_DC_Converters/CAD/SHANBO_SHB-5W.SLDPRT
aj_packages3d/3D/Power_Supplies/AC_DC_Converters/STL/Rohm_BP5039B12.STL
aj_packages3d/3D/RF_Modules/CAD/ESP-03.SLDPRT
aj_packages3d/3D/RF_Modules/CAD/RFM12.SLDPRT
aj_packages3d/3D/RF_Modules/CAD/RFM22B.SLDPRT
aj_packages3d/3D/RF_Modules/CAD/RFM96W.SLDPRT
aj_packages3d/3D/RF_Modules/STL/ESP-03.STL
aj_packages3d/3D/RF_Modules/STL/RFM12.STL
aj_packages3d/3D/RF_Modules/STL/RFM22B.STL
aj_packages3d/3D/RF_Modules/STL/RFM95W.STL
aj_packages3d/3D/RF_Modules/STL/Raytac_MDBT40.stl
aj_packages3d/3D/Terminal_Blocks/CAD/OSTTC022162.SLDPRT
aj_packages3d/3D/Terminal_Blocks/CAD/OSTVN02A150.SLDPRT
aj_packages3d/3D/Terminal_Blocks/CAD/OSTVN10A150.SLDPRT
aj_packages3d/3D/Terminal_Blocks/STL/OSTTC022162.STL
aj_packages3d/3D/Terminal_Blocks/STL/OSTVN02A150.STL
aj_packages3d/3D/Terminal_Blocks/STL/OSTVN03A150.STL
aj_packages3d/3D/Terminal_Blocks/STL/OSTVN10A150.STL
aj_packages3d/3D/Terminal_Blocks/STL/c-282834-8-c-3d.stl
aj_packages3d/3D/Test_Points/STL/TEST_POINT_PTH_KEYSTONE_5011.STL
aj_packages3d/3D/Test_Points/STL/TEST_POINT_PTH_KEYSTONE_5117.STL
aj_packages3d/3D/Test_Points/STL/TEST_POINT_SMT_KEYSTONE_5015.STL
aj_packages3d/3D/Transducers/STL/PS1240P02BT.stl
aj_packages3d/grabcad/espressiv/WEMOS D1 mini.step
aj_packages3d/grabcad/espressiv/WEMOS-D1-mini_detailed.SLDPRT
aj_packages3d/grabcad/espressiv/Wemos_d1_mini-detailed_assembly.SLDASM
aj_packages3d/grabcad/espressiv/hlk-pm01.step
