promesoft/KicadJE_LIB/aj_symbols/lib_master/Schematic_Component_Setup_Time_Study.xlsx

Library Name | Component Name | Date | Start Time | Stop Time | Time Duration (HR:MIN) | Goals | Accomplishments | Comments
Integrated_Circuits | USB2SERA10CFK | 2012-08-21 | 21:05:00 | 21:41:00 | 0:36:00
Connector | USB_Type_A_RA | 2012-12-03 | 14:30:00 | 15:05:00 | 0:35:00 |  |  | Schematic
Connector | Test Point 5011 | 2012-12-03 | 15:05:00 | 15:31:00 | 0:26:00 |  |  | PCB Footprint
Connector | USB_Type_A_RA | 2012-12-03 | 15:31:00 | 15:43:00 | 0:12:00 |  |  | PCB Footprint
Connector | USB_Mini_A_SMT | 2012-12-03 | 15:43:00 | 15:58:00 | 0:15:00 |  |  | PCB Footprint
 | USB_Mini_B_SMT
 | USB_Mini_AB_SMT
Electromechanical | Switch_Rocker_SPDT_ON_ON | 2012-12-04 | 8:05:00 | 8:45:00 | 0:40:00 |  |  | Schematic
Electromechanical | Switch_Slide_DPDT_ON_ON | 2012-12-04 | 10:13:00 | 10:20:00 | 0:07:00 |  |  | Schematic
Electromechanical | GRS-2012-2000_PTH | 2012-12-04 | 10:20:00 | 10:42:00 | 0:22:00 |  |  | PCB Footprint
Connector
