promesoft/KicadJE_LIB/aj_templates/MikroBUS_Board_L_Template/mikroBUS_Info/Can I Make My Own mikroBUS Boards.PNG

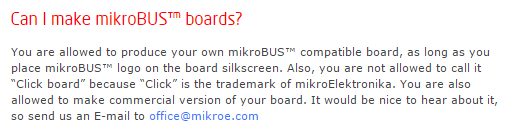
aj_templates/MikroBUS_Board_L_Template/mikroBUS_Info/Can I Make My Own mikroBUS Boards.PNG
