promesoft/KicadJE_LIB/(commit log)

2021-04-10 Footprint and faceplate cleanup
    [17653.stl, 475710001.stp, ArduinoMicro.SLDPRT, Arduino_Pro_Mini.SLDPRT, Arduino_Pro_Mini.STEP, Arduino_Pro_Mini.STL, B4B-PH-K-S.step, B4B-PH-SM4-TB.STEP]
2021-04-22 Powerfootprintupdated D16
